xplusinxH/zhufeng-robotic-arm/README.md

# zhufeng-robotic-arm
“zhufeng” The 6（+1）-axis robotic arm utilizes pure vision-based navigation, along with mechanical, control, vision, and hardware components.
