xplusinxH/zhufeng-robotic-arm/machine/README.md

# Machine Part

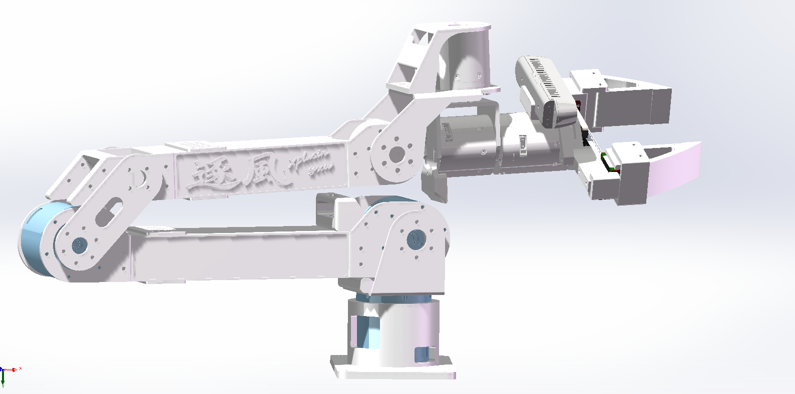
[picture p1: machine/assets/robotic-arm.png]
Robotic arm

零件与装配体使用SOLIDWORKS 2024或更高版本打开

## SUGGETIONS :
* 部分安装场景间距较窄建议使用整体采用平头螺丝
* 齿条建议采用钣金或CNC加工，实测PC耗材 5层墙 80填充密度的3D打印件仍会在远端出现跳齿
* 注意肩部和腕部的装配顺序，不然重复拆装可能会导致~~怒发冲冠~~
