xplusinxH/zhufeng-robotic-arm/docs/进度记录/2026-06-18-当前视觉进度与临时AprilTag任务.md

# 2026-06-18 当前视觉进度与临时 AprilTag 任务记录

## 当前项目进度

截至本记录，Jetson 视觉侧已经完成以下基础能力：

1. Jetson Nano 已完成 D435 运行环境配置。
2. 外部 30 GB 存储已改为 ext4，并挂载到 `/mnt/zhufeng_data`。
3. 项目运行目录改为 `/mnt/zhufeng_data/zhufeng/vision_jeason`。
4. D435 彩色流和深度流可稳定采集。
5. RGB-Depth 对齐验证已通过。
6. 鼠标点击测距和三维坐标显示已验证正常。
7. 已确认 D435 深度测量效果满足当前阶段要求，暂不需要深度尺度校正。

## 已知工作区状态

当前机械部分存在大量 SolidWorks 文件修改和临时锁文件。这些修改不属于视觉代码本次任务范围，
后续视觉侧提交不得自动包含这些 CAD 文件。

## 新增临时任务

用户提供了 Sukinee 机械臂视觉标定任务说明、`AprilTag0.pdf` 和 `AprilTag1.pdf`。
这些文件已备份到：

```text
docs/参考资料/2026-06-18-AprilTag机械臂临时标定任务
```

临时任务目标：

1. 使用相机识别机械臂底座附近的 `tag0`。
2. 使用相机识别执行器末端的 `tag1`。
3. 基于两个 tag 的相对位姿，计算执行器末端在底座 tag 坐标系下的位置。
4. 当对方通过 Jetson 串口发送坐标查询请求时，Jetson 返回当前执行器末端坐标。

## 重要边界

本临时任务只做视觉测量和串口响应：

- 不控制机械臂。
- 不连接 CAN 控制电机。
- 不设置电机零位。
- 不保存电机参数。
- 不启动 MoveIt 真机执行。
- 不做完整联合优化。

## 需要后续确认

1. 串口查询命令的精确格式。
2. 串口返回坐标的精确格式。
3. 返回坐标应使用毫米还是米。
4. 返回的是 `tag1` 原点坐标，还是需要换算到真正工具中心点。
5. `tag0` 和 `tag1` 的实际打印黑白图案边长。
