xplusinxH/zhufeng-robotic-arm/docs/进度记录/2026-06-15-视觉环境与D435采集.md

# 2026-06-15 视觉环境与 D435 采集进度记录

## 今日目标

完成 Jetson Nano 视觉运行环境准备，打通 RealSense D435 的 RGB-D 对齐采集链路，
并确定长期存储布局。

## 已完成事项

1. 确认 Jetson Nano 运行 L4T R32.7.4 / JetPack 4.6.4。
2. 确认 Python 3.6.9 和 OpenCV 3.2.0 可用。
3. 从源码编译并安装 librealsense 2.50.0。
4. 使用 RSUSB 后端，未修改 Jetson 内核。
5. 安装并验证 `pyrealsense2` Python 绑定。
6. 使用 `rs-enumerate-devices` 正确识别 RealSense D435。
7. 完成彩色流、深度流和深度对齐采集验证。
8. 完成 30 帧冒烟测试和十分钟稳定性测试。
9. 实现仓库中的 D435 对齐采集封装和相机检查脚本。
10. 建立独立的 `vision_jeason` Jetson 部署目录。

## 硬件与环境记录

| 项目 | 当前值 |
|---|---|
| Jetson 用户名 | `jetson` |
| L4T | R32.7.4 |
| JetPack | 4.6.4 |
| Python | 3.6.9 |
| OpenCV | 3.2.0 |
| librealsense | 2.50.0 |
| RealSense 后端 | RSUSB |
| D435 序列号 | `243122071071` |
| D435 固件 | `05.15.01.55` |

## 最终存储布局

eMMC 保存系统、运行库、运行配置和标定结果：

```text
/etc/zhufeng-vision/config
/etc/zhufeng-vision/calibration
```

外部 30 GB 存储已格式化为 ext4，UUID 为：

```text
06b4e18a-9a14-4a1e-bec3-8a9ace002fe1
```

固定挂载路径：

```text
/mnt/zhufeng_data
```

项目运行路径：

```text
/mnt/zhufeng_data/zhufeng/vision_project
```

## 问题与处理

### 外部盘只读

外部盘原文件系统为 `vfat`。在其中克隆 Git 仓库并编译动态库时，由于 vfat 不支持
Linux 符号链接，目录结构损坏，内核将文件系统自动设置为只读。

处理过程：

1. 使用 `fsck.vfat` 确认并修复损坏。
2. 将外部盘重新格式化为 ext4。
3. 固定挂载到 `/mnt/zhufeng_data`。
4. 验证 ext4 外部盘可正常读写。

后续不得将 Linux 项目工作盘格式化为 vfat。

### Python 绑定无法导入

`pyrealsense2` 安装在 `/usr/local/lib/python3.6/pyrealsense2`，不在默认搜索路径。
通过以下 `.pth` 配置解决：

```bash
/usr/local/lib/python3.6/dist-packages/pyrealsense2.pth
```

## 当前验收结果

- D435 可通过 USB 3.2 正确识别。
- `pyrealsense2` 可导入。
- 彩色流和深度流均为 640x480、30 FPS。
- 深度帧能够对齐到彩色帧。
- 中心点深度可正常读取。
- 十分钟连续采集无异常。
- 外部 ext4 存储可正常读写。

## 下一阶段

1. 读取并保存 D435 相机内参。
2. 增加 RGB 与深度对齐的可视化验证。
3. 采集空桌面数据。
4. 实现桌面平面标定。
5. 建立相机坐标系到机械臂工作坐标系的标定流程。
