xplusinxH/zhufeng-robotic-arm/docs/参考资料/2026-06-18-AprilTag机械臂临时标定任务/Sukinee机械臂视觉标定任务执行说明-联合优化版.txt

# Sukinee 机械臂视觉标定任务执行说明：联合优化版

## 0. 本任务的目标

本任务不是让视觉系统控制机械臂，也不是做 MoveIt 真机执行。

本任务目标是搭建一条外部视觉测量链路：

```text
固定外部相机
→ 标定后的 camera_info
→ AprilTag 检测
→ 输出末端 tag_tool0 在相机坐标系下的位姿
→ 多姿态采样
→ 和 motor_pos / q_urdf 样本对齐
→ 联合优化 motor_to_urdf software zero offset、base_link -> camera、tool0 -> tag_tool0
```

最终我们希望用视觉测量数据回答：

```text
当前 motor_pos -> q_urdf -> URDF FK 预测出的末端位置，
和真实机械臂末端位置相比误差是多少？

能否通过多姿态视觉样本修正 Joint1-Joint6 的 software zero offset？

能否同时反解：
1. base_link -> camera
2. tool0 -> tag_tool0
从而避免用手测外参？
```

本版第一阶段联合优化：

```text
1. Joint1-Joint6 的 q_urdf 零位修正量 Δq
2. base_link -> camera 的固定外参
3. tool0 -> tag_tool0 的固定外参
```

仍然不优化：

```text
1. 连杆长度
2. 关节轴方向
3. 完整 URDF 几何
4. 电机硬件零位
5. CAN_ID
6. 电机参数
7. MoveIt 真机执行
8. Gazebo effort / damping / torque / gravity_scale 真机参数
```

后续优化完成后，只输出新的 software-only offset JSON，例如：

```text
sukinee_motor_to_urdf_offsets_calibrated.json
```

不会设置电机零位，不会保存电机参数。

---

## 1. 坐标链路说明

### 1.1 坐标系定义

本任务使用 4 个核心坐标系：

```text
B = base_link，机器人底座坐标系
C = camera_color_optical_frame，相机光学坐标系
E = tool0，URDF 里的末端坐标系
T = tag_tool0，贴在末端刚体上的 AprilTag 坐标系
```

记号约定：

```text
T_A_B 表示：从 B 坐标系变换到 A 坐标系。
```

例如：

```text
T_C_T = camera -> tag_tool0
T_B_C = base_link -> camera
T_B_E = base_link -> tool0
T_E_T = tool0 -> tag_tool0
```

### 1.2 AprilTag 直接测出来的量

AprilTag 视觉检测直接输出的是：

```text
T_C_T_i = 第 i 个样本下 camera -> tag_tool0
```

也就是：

```text
tag_tool0 在 camera 坐标系下的位姿。
```

这个量不是手测的，也不是优化出来的，而是每个采样姿态下由视觉系统直接观测得到。

它依赖：

```text
1. 正确的 camera_info
2. 正确的 tag 实测尺寸
3. 图像中稳定检测到 tag 四个角点
4. tag 没有严重反光、模糊、弯曲或遮挡
```

### 1.3 机械臂 FK 给出的量

机械臂侧有：

```text
motor_pos -> q_urdf -> URDF FK
```

当前 software-only 映射是：

```text
q_urdf[j] = sign[j] * (motor_pos[j] - motor_pos_at_urdf_zero[j])
```

URDF / Pinocchio FK 给出：

```text
T_B_E_i = 第 i 个样本下 base_link -> tool0
```

也就是：

```text
tool0 在 base_link 坐标系下的预测位姿。
```

### 1.4 为什么不需要手测 base_link -> camera 和 tool0 -> tag_tool0

我们要联合优化两个固定外参：

```text
T_B_C = base_link -> camera
T_E_T = tool0 -> tag_tool0
```

它们不是手测值。

它们是通过多姿态数据反解出来的固定未知量。

每个样本 i 都应满足：

```text
T_B_C * T_C_T_i ≈ T_B_E_i * T_E_T
```

左边：

```text
T_B_C * T_C_T_i
=
把视觉测到的 camera -> tag_tool0 转到 base_link 坐标系下
```

右边：

```text
T_B_E_i * T_E_T
=
机械臂 FK 算出的 base_link -> tool0
再接上 tool0 -> tag_tool0 的固定安装外参
```

联合优化的目标就是让所有样本的左右两边尽量一致。

### 1.5 优化完成后如何得到视觉测量的 tool0 位姿

优化完成后，我们有：

```text
T_B_C = base_link -> camera
T_E_T = tool0 -> tag_tool0
```

相机实时测到：

```text
T_C_T = camera -> tag_tool0
```

那么视觉测量的：

```text
base_link -> tool0
```

可以由下面公式得到：

```text
T_B_E_visual = T_B_C * T_C_T * inverse(T_E_T)
```

也就是：

```text
base_link -> tool0 的视觉测量值
=
base_link -> camera
*
camera -> tag_tool0
*
tag_tool0 -> tool0
```

其中：

```text
camera -> tag_tool0：
由 AprilTag 每帧直接测量。

base_link -> camera：
由多姿态样本联合优化反解。

tag_tool0 -> tool0：
等于 inverse(tool0 -> tag_tool0)，由多姿态样本联合优化反解。
```

所以不需要 Tony 用尺子精确手测这三个变换。

Tony 和视觉同事只需要保证：

```text
1. 相机采样期间不动
2. tag_tool0 相对末端刚体不动
3. tag_base_ref 相对环境不动
4. camera_info 正确
5. tag_size_m 正确
6. 姿态样本足够丰富
7. robot sample 和 vision sample 的 sample_id 严格一致
```

---

## 2. 角色分工

### 2.1 Tony 负责

因为只有 Tony 有 Ubuntu 24.04 + ROS 2 Jazzy + Sukinee 机械臂环境，所以以下事情必须在 Tony 的电脑和机械臂现场完成：

```text
1. 安装和启动 ROS 2 相关软件
2. 启动 USB 相机节点
3. 加载 camera_info
4. 启动 AprilTag 检测节点
5. 启动 zero_drag 或其他安全拖动方式
6. 操作机械臂移动到采样姿态
7. 记录 Joint1-Joint6 motor_pos
8. 记录 Joint1-Joint6 q_urdf
9. 维护 sample_id
10. 保存 robot sample
11. 保存最终数据
12. 确保 MoveIt 不接真机
13. 确保视觉同事不操作 CAN 或电机
```

### 2.2 视觉同事负责

视觉同事即使没有 Ubuntu/ROS 环境，也可以负责：

```text
1. 确认 tag 打印尺寸和图案质量
2. 指导 tag_tool0 安装
3. 指导 tag_base_ref 安装
4. 指导相机安装位置
5. 检查图像质量
6. 检查 camera_info 是否合理
7. 检查 AprilTag 检测是否稳定
8. 判断每个采样姿态下 tag 是否可用
9. 检查静态 tag 抖动
10. 检查 base_ref start / middle / end 是否漂移
11. 审核 vision samples 数据质量
12. 输出视觉质量报告
```

视觉同事可以远程指导 Tony 操作 ROS 相机和 AprilTag，但不能操作 CAN、电机、MoveIt 真机执行。

---

## 3. 安全边界

视觉同事不要做以下事情：

```text
1. 不接 can0
2. 不控制电机
3. 不发送 Type1 torque_ff
4. 不发送 Type4 disable
5. 不发送 Type6 set zero
6. 不保存电机参数
7. 不修改 CAN_ID
8. 不启动 MoveIt 真机执行
9. 不启动 ros2_control 真机 hardware interface
10. 不让 FollowJointTrajectory 接真实机械臂
```

Tony 操作机械臂时必须保持：

```text
1. MoveIt 只允许 mock/demo
2. MoveIt 不允许真机执行
3. 不设置电机零位
4. 不保存电机参数
5. 不改 CAN_ID
6. Joint7 / left_finger / right_finger 不纳入整臂标定对象
```

stop-all 路径：

```bash
/home/zzj/sukinee_ws/src/sukinee_urdf/scripts/zero_drag/sukinee_stop_all_motors.py
```

如果使用 zero_drag 真实拖动，要明确：

```text
这涉及真实机械臂控制。
zero_drag 可能发送真实 Type1 torque_ff。
zero_drag 结束或异常时应通过 Type4 disable 路径关闭电机。
必须准备 stop-all 脚本。
MoveIt 仍不允许真机执行。
```

can0 准备命令：

```bash
cd /home/zzj/sukinee_ws

sudo ip link set can0 type can bitrate 1000000 restart-ms 100
sudo ip link set can0 up

ip -details -statistics link show can0
```

正常应看到：

```text
can state ERROR-ACTIVE
bitrate 1000000
berr-counter tx 0 rx 0
```

如果出现：

```text
Device or resource busy
```

执行：

```bash
sudo ip link set can0 down
```

然后重新执行上面的 can0 命令。

---

## 4. 推荐硬件与 tag 尺寸

### 4.1 相机

建议使用普通 USB 相机，优先选择：

```text
1. 能在 Linux 下稳定识别为 /dev/video*
2. 分辨率至少 1280x720，最好 1920x1080
3. 支持固定曝光更好
4. 支持固定焦距更好
5. 尽量避免自动对焦来回拉焦
6. 采样期间必须固定，不能手持
```

### 4.2 AprilTag family

建议使用：

```text
tag36h11
```

### 4.3 tag 尺寸

建议：

```text
tag_tool0: 40 mm × 40 mm
tag_base_ref: 60 mm × 60 mm
```

如果末端 40 mm 太大：

```text
tag_tool0: 30 mm × 30 mm
tag_base_ref: 50 mm × 50 mm
```

注意：

```text
这里的尺寸是 AprilTag 黑白图案主体边长，
不是整张纸边长，
不是外部白边边长。
```

打印要求：

```text
1. 100% 原尺寸打印
2. 不要“适合页面”
3. 不要自动缩放
4. 保留白边
5. 贴到硬板上
6. 保持平整
7. 不要弯曲
8. 不要反光
9. 不要皱折
10. 打印后用尺子重新测量 tag 图案主体边长
11. 记录实测尺寸，单位 m
```

tag 尺寸记录不是为了手测外参，而是为了让 AprilTag 正确估计 `camera -> tag_tool0` 的 3D pose。

---

## 5. tag 安装要求

### 5.1 tag_tool0 安装位置

`tag_tool0` 是末端 tag，用来测量真实末端刚体位姿。

必须满足：

```text
1. 不贴在 left_finger
2. 不贴在 right_finger
3. 不贴在任何会随 Joint7 / 夹爪开合运动的部件上
4. 固定在 Joint6 之后、但不随夹爪开合变化的刚性部件上
5. 推荐固定在 Link8 / gripper 固定座 / tool0 附近刚性安装板
6. 可以用硬纸板、泡沫板、薄亚克力、3D 打印片做小旗子支架
7. 支架必须刚性固定，不能晃动
8. 不挡夹爪开合
9. 不碰机械臂自身
10. 尽量朝向相机
```

本版不要求手工精确测量 `tool0 -> tag_tool0`，因为该外参会在联合优化中求解。

但是必须保证：

```text
tag_tool0 相对于末端刚体是固定常量。
```

如果 tag 会晃、会弯、会随 Joint7 开合，那么 `tool0 -> tag_tool0` 就不是常量，数据会失效。

### 5.2 tag_base_ref 安装位置

`tag_base_ref` 是底座附近参考 tag，用于检查相机/环境是否移动。

必须满足：

```text
1. 固定在机器人底座附近的桌面、底板或固定硬板上
2. 不贴在 Joint1 会转动的部分
3. 不要求位于 base_link 原点
4. 采样期间不能移动
5. 采样开始前、结束后、中途偶尔能看到即可
```

本版中 `tag_base_ref` 不直接用于求 `base_link -> camera`，因为 `base_link -> camera` 会由联合优化反解。

`tag_base_ref` 的主要作用是：

```text
1. 采样开始前记录 camera -> tag_base_ref
2. 采样中途记录 camera -> tag_base_ref
3. 采样结束后记录 camera -> tag_base_ref
4. 对比三者，判断相机或 base_ref 是否移动
```

### 5.3 是否要求两个 tag 同时可见

不要求。

规则是：

```text
1. 每个有效采样点必须看到 tag_tool0
2. tag_base_ref 不需要每一帧都看到
3. tag_base_ref 用于采样开始、结束、中途检查相机是否移动
4. 如果某个机械臂姿态看不到 tag_tool0，就跳过该姿态
```

---

## 6. 拍照记录要求

拍照记录不是为了用照片直接计算外参，而是为了排查问题。

照片要证明：

```text
1. tag_tool0 固定在末端刚体上，不随夹爪动
2. tag_base_ref 固定在环境中，不随机械臂动
3. camera 固定在环境中，采样期间不会动
```

创建目录：

```bash
mkdir -p /home/zzj/sukinee_ws/vision_calibration/photos
```

建议保存以下照片：

```text
/home/zzj/sukinee_ws/vision_calibration/photos/tag_tool0_mount.jpg
/home/zzj/sukinee_ws/vision_calibration/photos/tag_tool0_closeup.jpg
/home/zzj/sukinee_ws/vision_calibration/photos/tag_tool0_side.jpg
/home/zzj/sukinee_ws/vision_calibration/photos/tag_tool0_with_fingers.jpg

/home/zzj/sukinee_ws/vision_calibration/photos/tag_base_ref_mount.jpg
/home/zzj/sukinee_ws/vision_calibration/photos/tag_base_ref_closeup.jpg
/home/zzj/sukinee_ws/vision_calibration/photos/tag_base_ref_overview.jpg

/home/zzj/sukinee_ws/vision_calibration/photos/camera_setup.jpg
/home/zzj/sukinee_ws/vision_calibration/photos/camera_setup_mount.jpg
/home/zzj/sukinee_ws/vision_calibration/photos/camera_view_workspace.jpg
```

如果只保留最少 3 张，至少保留：

```text
tag_tool0_mount.jpg
tag_base_ref_mount.jpg
camera_setup.jpg
```

### 6.1 tag_tool0_mount.jpg 怎么拍

主照片应从末端斜前方 45° 拍，画面里同时看到：

```text
1. tag_tool0
2. tag 背后的安装板或支架
3. Link8 / gripper 固定座 / tool0 附近刚性结构
4. left_finger
5. right_finger
6. tag 与夹爪手指的相对关系
```

这张照片必须能证明：

```text
tag_tool0 不在 left_finger / right_finger 上，
也不会随 Joint7 夹爪开合运动。
```

### 6.2 tag_tool0_closeup.jpg 怎么拍

靠近拍 tag，确保看清：

```text
1. 黑白图案
2. 四个角
3. 白边
4. 是否平整
5. 是否反光
6. 是否皱折
7. 是否被胶带遮住
```

### 6.3 tag_tool0_side.jpg 怎么拍

从侧面拍 tag 和支架，重点看：

```text
1. 支架厚度
2. 固定方式
3. 是否软、长、容易晃
4. tag 平面是否弯曲
```

### 6.4 tag_tool0_with_fingers.jpg 怎么拍

让画面同时包含：

```text
1. tag
2. left_finger
3. right_finger
4. 夹爪固定座
```

目的是证明：

```text
手指开合时 tag 不会跟着动。
```

### 6.5 tag_base_ref_mount.jpg 怎么拍

从上方斜拍，画面里同时看到：

```text
1. tag_base_ref
2. 机器人底座
3. Joint1 附近区域
4. 桌面 / 底板 / 固定硬板
```

这张照片必须能证明：

```text
tag_base_ref 不在 Joint1 会旋转的部分上，
而是固定在静止环境中。
```

### 6.6 camera_setup.jpg 怎么拍

拍全局布置，画面里看到：

```text
1. 相机本体
2. 相机支架 / 三脚架 / 固定架
3. 机器人整体
4. tag_tool0 大致工作区
5. tag_base_ref 所在区域
6. 相机和机械臂之间的大致空间关系
```

不要只拍相机特写。

### 6.7 camera_view_workspace.jpg 怎么获取

用 ROS 图像窗口截图。

打开：

```bash
rqt_image_view
```

选择相机图像 topic，例如：

```text
/image_raw
```

或：

```text
/camera/image_raw
```

截图保存为：

```text
/home/zzj/sukinee_ws/vision_calibration/photos/camera_view_workspace.jpg
```

截图中最好能看到：

```text
1. tag_tool0 清晰可见
2. tag 不在画面边缘
3. tag 不是太小
4. 常用工作区覆盖够用
5. 没有严重反光或背光
```

---

## 7. 相机安装位置

推荐位置：

```text
机械臂前上方或侧前上方
俯视角大约 30°–60°
相机固定在三脚架、支架或刚性架上
覆盖常用工作区，不追求覆盖全部极限姿态
```

布置要求：

```text
1. 相机不能手持
2. 采样期间不能移动相机
3. 避免强反光
4. 避免背光
5. 保持光照稳定
6. 机械臂运动后停稳再采样
7. tag 在画面中不要太小
8. tag 不要太靠近画面边缘
9. tag 不要严重倾斜到只剩很窄的透视形状
10. 相机线缆不要拉扯相机
11. 人走动或机械臂运动时不要碰到支架
```

---

## 8. 软件安装

在 Tony 的 Ubuntu 24.04 + ROS 2 Jazzy 环境下执行：

```bash
sudo apt update

sudo apt install -y \
  ros-jazzy-apriltag-ros \
  ros-jazzy-v4l2-camera \
  ros-jazzy-camera-calibration \
  ros-jazzy-image-view \
  ros-jazzy-image-proc \
  ros-jazzy-tf2-ros \
  ros-jazzy-rqt-image-view \
  v4l-utils
```

验证安装：

```bash
source /opt/ros/jazzy/setup.bash

ros2 pkg list | grep apriltag
ros2 pkg list | grep v4l2
ros2 pkg list | grep camera_calibration
ros2 pkg list | grep image_view
```

预期至少能看到：

```text
apriltag_ros
v4l2_camera
camera_calibration
image_view
```

---

## 9. 检查 USB 相机

插入相机后检查设备：

```bash
ls /dev/video*
```

查看相机设备信息：

```bash
v4l2-ctl --list-devices
```

查看相机支持格式：

```bash
v4l2-ctl --device=/dev/video0 --list-formats-ext
```

这里 `/dev/video0` 需要按实际设备修改。

---

## 10. 启动相机节点

先用最小命令测试：

```bash
source /opt/ros/jazzy/setup.bash

ros2 run v4l2_camera v4l2_camera_node \
  --ros-args \
  -p video_device:=/dev/video0 \
  -p image_size:="[1280,720]" \
  -p camera_frame_id:=camera_color_optical_frame
```

另开一个终端检查 topic：

```bash
source /opt/ros/jazzy/setup.bash

ros2 topic list | grep -E "image|camera"
```

检查图像频率：

```bash
ros2 topic hz /image_raw
```

或者如果 topic 带 namespace：

```bash
ros2 topic hz /camera/image_raw
```

打开画面：

```bash
rqt_image_view
```

或：

```bash
ros2 run image_view image_view --ros-args -r image:=/image_raw
```

验收标准：

```text
1. 能看到实时图像
2. 图像不卡死
3. tag 在画面中清楚
4. 不明显过曝
5. 不明显欠曝
6. 不明显运动模糊
7. 相机 frame_id 明确
```

---

## 11. 相机内参标定与验证

本章节不能删除，因为 AprilTag 3D pose 依赖正确 camera_info。

如果相机已经完成内参标定，本章节仍要做“加载验证”。

如果相机更换、分辨率更换、镜头焦距变化、标定 YAML 丢失，则必须重新标定。

### 11.1 为什么必须有正确 camera_info

AprilTag 即使能检测出 ID，如果没有正确 camera_info，3D pose 也不可靠。

必须保证：

```text
1. camera_info 来自当前相机
2. camera_info 对应当前分辨率
3. camera_info 对应当前焦距/镜头设置
4. tag size 使用实际测量尺寸
```

### 11.2 准备标定板

可以使用棋盘格，例如：

```text
棋盘格内角点：8x6
方格尺寸：25 mm
```

实际参数必须按真实标定板填写。

### 11.3 启动相机

```bash
source /opt/ros/jazzy/setup.bash

ros2 run v4l2_camera v4l2_camera_node \
  --ros-args \
  -p video_device:=/dev/video0 \
  -p image_size:="[1280,720]" \
  -p camera_frame_id:=camera_color_optical_frame
```

### 11.4 运行单目标定

如果图像 topic 是 `/image_raw`：

```bash
source /opt/ros/jazzy/setup.bash

ros2 run camera_calibration cameracalibrator \
  --size 8x6 \
  --square 0.025 \
  --ros-args \
  -r image:=/image_raw \
  -r camera:=/camera
```

如果图像 topic 是 `/camera/image_raw`：

```bash
ros2 run camera_calibration cameracalibrator \
  --size 8x6 \
  --square 0.025 \
  --ros-args \
  -r image:=/camera/image_raw \
  -r camera:=/camera
```

标定时移动棋盘格，让它覆盖：

```text
1. 画面左上
2. 画面右上
3. 画面左下
4. 画面右下
5. 画面中心
6. 近距离
7. 远距离
8. 不同倾斜角
```

标定完成后保存 YAML。

### 11.5 保存相机内参

建议保存到：

```bash
mkdir -p ~/.ros/camera_info
```

文件名建议：

```text
sukinee_usb_camera.yaml
```

路径：

```text
~/.ros/camera_info/sukinee_usb_camera.yaml
```

### 11.6 启动相机时加载 camera_info

示例：

```bash
source /opt/ros/jazzy/setup.bash

ros2 run v4l2_camera v4l2_camera_node \
  --ros-args \
  -p video_device:=/dev/video0 \
  -p image_size:="[1280,720]" \
  -p camera_frame_id:=camera_color_optical_frame \
  -p camera_info_url:=file:///home/zzj/.ros/camera_info/sukinee_usb_camera.yaml
```

检查 camera_info：

```bash
ros2 topic echo /camera_info --once
```

或：

```bash
ros2 topic echo /camera/camera_info --once
```

验收标准：

```text
1. camera_info 里 width/height 与图像分辨率一致
2. K 矩阵不是全 0
3. D 畸变参数存在
4. P 矩阵存在
5. header.frame_id 是当前相机 frame
6. 重启相机后 camera_info 仍能加载
```

### 11.7 是否需要 image_proc

如果 AprilTag 节点使用的是 rectified image，例如 `image_rect`，需要启动 `image_proc` 生成 rectified 图像。

如果 AprilTag 节点直接使用 raw image 并配合 camera_info，也可以先按当前节点要求运行。

实际以本机 `apriltag_ros` 的 topic 要求为准。

检查当前 AprilTag 节点需要的输入 topic：

```bash
ros2 pkg executables apriltag_ros
ros2 node info /apriltag_detector
```

如果 node 名不同，用实际 node 名替换。

---

## 12. 创建视觉标定工作目录

```bash
mkdir -p /home/zzj/sukinee_ws/vision_calibration/config
mkdir -p /home/zzj/sukinee_ws/vision_calibration/data
mkdir -p /home/zzj/sukinee_ws/vision_calibration/photos
mkdir -p /home/zzj/sukinee_ws/vision_calibration/reports
mkdir -p /home/zzj/sukinee_ws/vision_calibration/results
```

记录 tag 实测尺寸：

```bash
cat > /home/zzj/sukinee_ws/vision_calibration/config/tag_measured_sizes.yaml <<'YAML'
tag_family: tag36h11

tags:
  tag_tool0:
    id: 0
    measured_size_m: 0.0400
    mounted_on: "Link8 / gripper fixed plate / rigid tool0 bracket"
    moves_with_joint7: false
    used_for: "end-effector calibration"

  tag_base_ref:
    id: 1
    measured_size_m: 0.0600
    mounted_on: "fixed table or fixed base board near robot base"
    moves_with_robot: false
    used_for: "camera drift check only"
YAML
```

注意：

```text
0.0400 和 0.0600 必须换成尺子实际测量的 tag 图案主体边长，单位 m。
```

---

## 13. 配置 AprilTag

建立 AprilTag 配置文件。具体字段名可能需要根据本机安装版本的 `apriltag_ros` 示例微调，但核心信息必须包含：

```bash
cat > /home/zzj/sukinee_ws/vision_calibration/config/apriltag_sukinee.yaml <<'YAML'
family: tag36h11
size: 0.0400

tags:
  - id: 0
    size: 0.0400
    name: tag_tool0
  - id: 1
    size: 0.0600
    name: tag_base_ref
YAML
```

验收标准：

```text
1. tag_tool0 的 id 固定
2. tag_base_ref 的 id 固定
3. tag size 使用实测值
4. frame name 不用 tag0/tag1 这种含糊名字
5. frame name 使用 tag_tool0 / tag_base_ref
```

如果本机 `apriltag_ros` 参数名和上面不同，先查官方示例或执行：

```bash
ros2 pkg prefix apriltag_ros
ros2 pkg executables apriltag_ros
```

---

## 14. 启动 AprilTag 检测

先启动相机，确保 image 和 camera_info 都有。

检查 topic：

```bash
ros2 topic list
```

常见 topic 可能是：

```text
/image_raw
/camera_info
```

也可能是：

```text
/camera/image_raw
/camera/camera_info
```

查看可用 executable：

```bash
ros2 pkg prefix apriltag_ros
ros2 pkg executables apriltag_ros
```

如果有可直接运行的 node，可以按实际 executable 启动，并 remap image/camera_info。

示例 1：

```bash
ros2 run apriltag_ros apriltag_node \
  --ros-args \
  -r image_rect:=/image_raw \
  -r camera_info:=/camera_info \
  --params-file /home/zzj/sukinee_ws/vision_calibration/config/apriltag_sukinee.yaml
```

示例 2：

```bash
ros2 run apriltag_ros apriltag_node \
  --ros-args \
  -r image_rect:=/camera/image_raw \
  -r camera_info:=/camera/camera_info \
  --params-file /home/zzj/sukinee_ws/vision_calibration/config/apriltag_sukinee.yaml
```

检查检测结果：

```bash
ros2 topic list | grep detection
ros2 topic echo /detections --once
```

检查 TF：

```bash
ros2 run tf2_ros tf2_echo camera_color_optical_frame tag_tool0
```

如果 frame 名不同，先查看 TF tree：

```bash
ros2 run tf2_tools view_frames
```

验收标准：

```text
1. /detections 能看到 tag id
2. 检测结果里有 pose
3. tf2_echo 能看到 camera frame 到 tag_tool0 的 transform
4. tag 静止时 transform 不应大幅跳动
5. 移动 tag 后 transform 方向变化符合直觉
```

---

## 15. 静态稳定性测试

这一步必须做。否则后续采样数据不可信。

### 15.1 测试方法

让机械臂和 tag_tool0 完全静止。

条件：

```text
1. 机械臂完全静止
2. 相机完全固定
3. tag_tool0 清晰可见
4. 光照稳定
5. 不碰相机、不碰 tag
```

连续采集 100–200 帧：

```bash
ros2 topic echo /detections > /home/zzj/sukinee_ws/vision_calibration/data/static_tag_tool0_raw.txt
```

同时可以保存 TF：

```bash
ros2 run tf2_ros tf2_echo camera_color_optical_frame tag_tool0 \
  > /home/zzj/sukinee_ws/vision_calibration/data/static_tag_tool0_tf.txt
```

### 15.2 统计内容

统计 tag_tool0 pose 的：

```text
1. x 均值、标准差、最大最小
2. y 均值、标准差、最大最小
3. z 均值、标准差、最大最小
4. roll/pitch/yaw 或 quaternion 抖动
5. 检测成功率
6. 是否有明显跳变帧
```

### 15.3 验收标准

粗略标准：

```text
优秀：静止 position 抖动 1–3 mm
可用：静止 position 抖动 3–5 mm
勉强：静止 position 抖动 5–10 mm
不建议用：静止 position 抖动 > 10 mm 或经常跳变
```

如果静止 tag 的位置抖动达到厘米级，先不要进入多姿态采样，需要先排查：

```text
1. 相机内参不准
2. tag 太小
3. tag 太远
4. 图像模糊
5. 曝光不稳定
6. tag 反光
7. 相机支架晃动
8. tag 支架晃动
9. tag size 填错
10. camera_info 分辨率和实际图像分辨率不一致
```

---

## 16. base_ref 漂移检查

### 16.1 采样开始前

让相机看到 `tag_base_ref`，记录：

```bash
ros2 run tf2_ros tf2_echo camera_color_optical_frame tag_base_ref \
  > /home/zzj/sukinee_ws/vision_calibration/data/base_ref_start_tf.txt
```

### 16.2 采样中途

每 30–40 个有效样本记录一次：

```bash
ros2 run tf2_ros tf2_echo camera_color_optical_frame tag_base_ref \
  > /home/zzj/sukinee_ws/vision_calibration/data/base_ref_middle_001_tf.txt
```

### 16.3 采样结束后

```bash
ros2 run tf2_ros tf2_echo camera_color_optical_frame tag_base_ref \
  > /home/zzj/sukinee_ws/vision_calibration/data/base_ref_end_tf.txt
```

验收标准：

```text
start / middle / end 三次 base_ref 位姿不能明显变化。
如果变化达到几厘米，说明相机或 base_ref 可能移动了，这批样本要标记为可疑或废弃。
```

---

## 17. 采样策略

由于本版要联合优化：

```text
1. Joint1-Joint6 zero offset 修正量
2. base_link -> camera
3. tool0 -> tag_tool0
```

变量比原版更多，所以样本数量必须增加。

### 17.1 小规模试采样

正式采样前先采：

```text
20 个有效样本
```

目的：

```text
1. 验证 robot sample 和 vision sample 能按 sample_id 对齐
2. 验证 AprilTag pose 数据格式可读
3. 验证 FK 数据可读
4. 验证联合优化脚本能跑通
5. 验证 frame 方向没有明显反
6. 验证结果没有明显离谱
```

小样本试采不作为最终标定结果。

### 17.2 正式采样数量

试采通过后，正式采：

```text
训练样本：100 个有效样本
验证样本：20–30 个有效样本
```

最低建议：

```text
训练样本不少于 80 个
验证样本不少于 20 个
```

不建议只采 30 个，因为联合优化变量较多，样本太少容易出现外参和 joint offset 互相混淆。

### 17.3 姿态覆盖要求

样本姿态要覆盖：

```text
1. 左侧
2. 右侧
3. 中间
4. 近处
5. 远处
6. 高位
7. 中位
8. 低位
9. Joint1 有明显变化
10. Joint2 / Joint3 有明显变化
11. Joint4 / Joint5 / Joint6 有适当变化
12. tool0 的位置要变化
13. tool0 的姿态也要变化
```

特别注意：

```text
如果 tool0 姿态几乎不变，tool0 -> tag_tool0 很难被稳定反解。
因此 Joint4 / Joint5 / Joint6 也要有适当变化。
```

不要采：

```text
1. 接近碰撞的姿态
2. 接近机械限位的姿态
3. tag 看不到的姿态
4. tag 在画面边缘的姿态
5. tag 角度太斜的姿态
6. 机械臂还在晃的姿态
7. 相机可能被碰到的姿态
8. Joint7 夹爪状态变化导致 tag 相对末端变化的姿态
```

---

## 18. 每个样本的采样动作

每个样本按以下流程执行。

以 `S0001` 为例：

```text
1. Tony 说：准备采 S0001
2. Tony 负责把机械臂移动到一个安全姿态
3. 停止移动
4. 等待机械臂完全静止 1–2 秒
5. 视觉同事确认 tag_tool0 清晰可见
6. 视觉侧连续取 10–20 帧 camera -> tag_tool0
7. 对 10–20 帧做中位数或稳健平均
8. 视觉侧保存 S0001 的 vision sample
9. Tony 记录 S0001 的 motor_pos 和 q_urdf
10. Tony 保存 S0001 的 robot sample
11. 双方确认 S0001 完成
12. 进入 S0002
```

sample_id 命名建议：

```text
S0001
S0002
S0003
...
```

视觉侧和机械臂侧必须使用相同 sample_id。

不要出现：

```text
视觉侧叫 S0012，robot 侧叫 S0013
```

---

## 19. 视觉侧样本文件格式

建议视觉侧输出 JSONL，每行一个样本。

小样本试采：

```text
/home/zzj/sukinee_ws/vision_calibration/data/vision_samples_trial.jsonl
```

正式训练集：

```text
/home/zzj/sukinee_ws/vision_calibration/data/vision_samples_train_YYYYMMDD.jsonl
```

正式验证集：

```text
/home/zzj/sukinee_ws/vision_calibration/data/vision_samples_validation_YYYYMMDD.jsonl
```

每个有效样本格式：

```json
{
  "sample_id": "S0001",
  "timestamp_vision": "2026-06-xxTxx:xx:xx.xxx",
  "camera_frame": "camera_color_optical_frame",
  "tag_frame": "tag_tool0",
  "tag_family": "tag36h11",
  "tag_id": 0,
  "tag_size_m": 0.0400,
  "T_C_T": {
    "meaning": "camera -> tag_tool0",
    "position": {
      "x": 0.0,
      "y": 0.0,
      "z": 0.0
    },
    "orientation_xyzw": {
      "x": 0.0,
      "y": 0.0,
      "z": 0.0,
      "w": 1.0
    }
  },
  "frame_count_used": 15,
  "detection_quality": {
    "decision_margin": null,
    "hamming": null,
    "center_px": [0.0, 0.0]
  },
  "valid": true,
  "reject_reason": ""
}
```

如果某个样本看不到 tag 或质量差，也可以记录为 invalid：

```json
{
  "sample_id": "S0012",
  "valid": false,
  "reject_reason": "tag_tool0 not visible"
}
```

有效样本必须满足：

```text
1. tag_tool0 可见
2. pose 存在
3. tag id 正确
4. tag size 正确
5. 图像不模糊
6. tag 不在画面边缘
7. 检测没有明显跳变
8. 连续 10–20 帧中没有明显 outlier
```

---

## 20. Tony 侧样本文件格式

Tony 记录 robot side。

小样本试采：

```text
/home/zzj/sukinee_ws/vision_calibration/data/robot_samples_trial.jsonl
```

正式训练集：

```text
/home/zzj/sukinee_ws/vision_calibration/data/robot_samples_train_YYYYMMDD.jsonl
```

正式验证集：

```text
/home/zzj/sukinee_ws/vision_calibration/data/robot_samples_validation_YYYYMMDD.jsonl
```

每行格式建议：

```json
{
  "sample_id": "S0001",
  "timestamp_robot": "2026-06-xxTxx:xx:xx.xxx",
  "offset_file": "/home/zzj/sukinee_ws/sukinee_motor_to_urdf_offsets.json",
  "motor_pos": {
    "Joint1": 0.0,
    "Joint2": 0.0,
    "Joint3": 0.0,
    "Joint4": 0.0,
    "Joint5": 0.0,
    "Joint6": 0.0
  },
  "q_urdf_current": {
    "Joint1": 0.0,
    "Joint2": 0.0,
    "Joint3": 0.0,
    "Joint4": 0.0,
    "Joint5": 0.0,
    "Joint6": 0.0
  }
}
```

注意：

```text
1. 只记录 Joint1-Joint6
2. Joint7 不纳入整臂标定
3. q_urdf_current 使用当前 software offset 计算
4. 不设置电机零位
5. 不保存电机参数
```

---

## 21. 后续建议新建的脚本

后续建议新建目录：

```bash
mkdir -p /home/zzj/sukinee_ws/src/sukinee_urdf/scripts/vision_calibration
```

### 21.1 视觉样本记录脚本

建议文件：

```text
/home/zzj/sukinee_ws/src/sukinee_urdf/scripts/vision_calibration/sukinee_record_vision_sample.py
```

功能：

```text
1. 输入 sample_id
2. 订阅 /detections 或读取 TF
3. 连续采 10–20 帧 tag_tool0 pose
4. 剔除明显跳变帧
5. 输出中位数 pose
6. 保存 vision_samples_*.jsonl
7. 不连接 can0
8. 不控制机械臂
9. 不启动 MoveIt
```

是否涉及真实控制：

```text
不涉及真实控制。
只读相机/AprilTag 数据。
```

### 21.2 robot 样本记录脚本

建议文件：

```text
/home/zzj/sukinee_ws/src/sukinee_urdf/scripts/vision_calibration/sukinee_record_robot_sample.py
```

功能：

```text
1. 输入 sample_id
2. 读取当前 motor_pos Joint1-Joint6
3. 使用当前 offset JSON 计算 q_urdf_current
4. 保存 robot_samples_*.jsonl
5. 不发送控制命令
6. 不启动 MoveIt
7. 不设置零位
8. 不保存参数
```

是否涉及真实控制：

```text
脚本本身不应发送真实控制命令。
但如果 motor_pos 来源于 zero_drag 或真实驱动反馈，运行环境涉及真实机械臂状态读取。
```

### 21.3 联合优化脚本

建议文件：

```text
/home/zzj/sukinee_ws/src/sukinee_urdf/scripts/vision_calibration/sukinee_optimize_zero_offsets_tooltag_camera.py
```

输入：

```text
1. robot_samples_train_YYYYMMDD.jsonl
2. vision_samples_train_YYYYMMDD.jsonl
3. robot_samples_validation_YYYYMMDD.jsonl
4. vision_samples_validation_YYYYMMDD.jsonl
5. /home/zzj/sukinee_ws/sukinee_motor_to_urdf_offsets.json
6. 当前 URDF/xacro 或生成后的 URDF
7. tag_measured_sizes.yaml
```

优化变量：

```text
1. Δq1-Δq6
2. T_B_C = base_link -> camera
3. T_E_T = tool0 -> tag_tool0
```

每个样本的目标：

```text
T_B_C * T_C_T_i ≈ FK(q_i_current + Δq) * T_E_T
```

输出：

```text
1. sukinee_motor_to_urdf_offsets_calibrated.json
2. camera_extrinsic_base_to_camera.yaml
3. tool0_to_tag_tool0.yaml
4. calibration_report_before_after.txt
5. residuals_train.csv
6. residuals_validation.csv
```

是否涉及真实控制：

```text
不涉及真实控制。
这是离线优化脚本。
不发送 CAN。
不控制电机。
不执行 MoveIt。
不改电机参数。
```

---

## 22. 联合优化结果如何写回 software offset

优化脚本建议优化：

```text
Δq1, Δq2, Δq3, Δq4, Δq5, Δq6
```

含义：

```text
q_corrected[j] = q_current[j] + Δq[j]
```

当前公式：

```text
q_current[j] = sign[j] * (motor_pos[j] - zero_old[j])
```

优化后写回新的 software zero：

```text
zero_new[j] = zero_old[j] - sign[j] * Δq[j]
```

注意：

```text
这只是生成新的 software-only offset JSON。
不是设置电机零位。
不是 Type6 set zero。
不是保存电机参数。
```

---

## 23. 每天采样前检查清单

视觉同事检查：

```bash
ros2 topic list
ros2 topic echo /camera_info --once
ros2 topic echo /detections --once
ros2 run tf2_ros tf2_echo camera_color_optical_frame tag_tool0
```

Tony 检查：

```text
1. 机械臂周围安全
2. stop-all 脚本路径明确
3. MoveIt 没有接真机
4. 当前 offset 文件路径明确
5. sample_id 从哪里开始明确
6. tag_tool0 没松
7. tag_base_ref 没动
8. 相机没动
9. 光照没明显变化
10. 图像清晰
11. camera_info 正常
12. base_ref_start 已记录
```

---

## 24. 采样结束后检查

采样结束后，视觉同事需要再次看一次 `tag_base_ref`。

目的：

```text
检查相机/底座关系是否发生变化。
```

如果开始、中途和结束的 base_ref 位姿差很多，说明：

```text
1. 相机可能移动了
2. base_ref 可能移动了
3. 数据可能不能用于标定
```

采样结束后保存：

```text
1. vision_samples_train_YYYYMMDD.jsonl
2. vision_samples_validation_YYYYMMDD.jsonl
3. static_tag_tool0_raw.txt 或 static_tag_report.txt
4. base_ref_start_tf.txt
5. base_ref_middle_*.txt
6. base_ref_end_tf.txt
7. tag_measured_sizes.yaml
8. camera_intrinsics.yaml
9. tag 安装照片
10. 视觉质量报告
```

Tony 保存：

```text
1. robot_samples_train_YYYYMMDD.jsonl
2. robot_samples_validation_YYYYMMDD.jsonl
3. 当前 sukinee_motor_to_urdf_offsets.json 副本
4. 当前 URDF/xacro 或生成后的 URDF
5. 采样当天说明
```

---

## 25. 视觉质量报告模板

视觉同事最终提交一个简短报告：

```text
1. 相机型号：
2. 分辨率：
3. 帧率：
4. 是否完成相机内参标定：
5. camera_info YAML 路径：
6. camera_info 是否已在 ROS 中验证加载：
7. tag family：
8. tag_tool0 id：
9. tag_tool0 实测尺寸：
10. tag_tool0 安装位置：
11. tag_tool0 是否随 Joint7 运动：
12. tag_base_ref id：
13. tag_base_ref 实测尺寸：
14. tag_base_ref 安装位置：
15. 静止 tag_tool0 连续 100–200 帧位置抖动：
16. 小样本试采数量：
17. 正式训练有效样本数量：
18. 正式验证有效样本数量：
19. 无效样本数量：
20. 常见丢失原因：
21. 采样开始/中途/结束 base_ref 是否一致：
22. 是否怀疑相机移动：
23. 是否怀疑 tag 支架晃动：
24. 是否存在明显反光、模糊、遮挡：
25. 备注：
```

---

## 26. 交付物清单

视觉同事最终交付：

```text
1. camera_intrinsics.yaml
2. tag_measured_sizes.yaml
3. apriltag_sukinee.yaml
4. vision_samples_trial.jsonl
5. vision_samples_train_YYYYMMDD.jsonl
6. vision_samples_validation_YYYYMMDD.jsonl
7. static_tag_report.txt
8. base_ref_start_tf.txt
9. base_ref_middle_*.txt
10. base_ref_end_tf.txt
11. tag_tool0_mount.jpg
12. tag_tool0_closeup.jpg
13. tag_tool0_side.jpg
14. tag_tool0_with_fingers.jpg
15. tag_base_ref_mount.jpg
16. tag_base_ref_closeup.jpg
17. tag_base_ref_overview.jpg
18. camera_setup.jpg
19. camera_setup_mount.jpg
20. camera_view_workspace.jpg
21. vision_quality_report.txt
```

Tony 这边交付给后续优化程序：

```text
1. robot_samples_trial.jsonl
2. robot_samples_train_YYYYMMDD.jsonl
3. robot_samples_validation_YYYYMMDD.jsonl
4. vision_samples_trial.jsonl
5. vision_samples_train_YYYYMMDD.jsonl
6. vision_samples_validation_YYYYMMDD.jsonl
7. sukinee_motor_to_urdf_offsets.json
8. 当前 URDF/xacro 或生成后的 URDF
9. tag_measured_sizes.yaml
10. camera_intrinsics.yaml
11. tag 安装照片
12. base_ref 漂移检查文件
```

联合优化脚本最终应输出：

```text
1. sukinee_motor_to_urdf_offsets_calibrated.json
2. camera_extrinsic_base_to_camera.yaml
3. tool0_to_tag_tool0.yaml
4. calibration_report_before_after.txt
5. residuals_train.csv
6. residuals_validation.csv
```

---

## 27. 最终验收标准

这项视觉工作不是“画面里能看到 tag”就算完成。

真正完成的标准是：

```text
1. 相机图像稳定
2. camera_info 是标定后的真实内参
3. camera_info 已经在 ROS 中验证加载
4. tag_tool0 固定在末端刚体上
5. tag_tool0 不随 Joint7 夹爪运动
6. tag_base_ref 固定不动
7. /detections 稳定输出
8. /tf 能输出 camera -> tag_tool0
9. 静止 tag 抖动可接受
10. base_ref start / middle / end 没有明显漂移
11. 小样本 20 个能跑通数据链路
12. 正式训练集 80–100 个以上有效样本
13. 正式验证集 20–30 个有效样本
14. 每个有效样本都有 sample_id
15. 每个有效样本能和 robot sample 对齐
16. 数据质量足够用于联合优化
17. validation after error 明显小于 validation before error
18. 优化出的 Δq 合理
19. 优化出的 base_link -> camera 大致符合真实相机位置
20. 优化出的 tool0 -> tag_tool0 大致符合 tag 实际安装位置
```

---

## 28. 不可信结果的典型表现

如果优化结果出现以下情况，不要直接使用 calibrated offset：

```text
1. validation 误差没有下降
2. train 误差下降但 validation 误差不下降
3. 某个 Δq 大到离谱，例如超过 0.5 rad，需要重点排查
4. tool0 -> tag_tool0 偏移几百毫米，但 tag 实际就在末端附近
5. base_link -> camera 跑到明显不可能的位置
6. 大量样本残差异常大
7. 残差集中在某些 sample_id，怀疑 sample_id 错位
8. base_ref 显示相机采样期间移动过
9. tag_tool0 支架照片显示可能晃动
10. camera_info 分辨率和实际图像分辨率不一致
```

出现这些问题时，优先排查：

```text
1. sample_id 是否错位
2. camera_info 是否正确
3. tag_size_m 是否写错
4. tag frame 方向是否理解反了
5. quaternion 顺序是否 xyzw
6. FK 使用的 URDF 是否为当前主 URDF
7. motor_to_urdf offset 是否为当前文件
8. tag_tool0 是否松动
9. 相机是否移动
10. Joint7 是否在采样中改变并影响 tag
```

---

## 29. 最小执行顺序

### 第一步：硬件固定与拍照

```text
1. 固定相机
2. 固定 tag_tool0
3. 固定 tag_base_ref
4. 拍照记录 tag_tool0
5. 拍照记录 tag_base_ref
6. 拍照记录 camera setup
7. 记录 tag 实测尺寸
```

通过条件：

```text
1. tag_tool0 不在手指上
2. tag_tool0 不随 Joint7 运动
3. tag_base_ref 不随机械臂运动
4. 相机固定可靠
```

### 第二步：相机和 camera_info 验证

```text
1. 启动 v4l2_camera
2. 检查 image topic
3. 检查 camera_info topic
4. 确认 camera_info 已加载
5. 如未标定或不匹配，则重新标定
```

通过条件：

```text
1. 图像稳定
2. camera_info 正确
3. 分辨率匹配
```

### 第三步：AprilTag 检测

```text
1. 配置 tag id 和 tag size
2. 启动 apriltag_ros
3. 检查 /detections
4. 检查 camera -> tag_tool0
5. 检查 tag 静止时是否稳定
```

通过条件：

```text
1. 能稳定识别 tag_tool0
2. camera -> tag_tool0 pose 稳定
```

### 第四步：静态稳定性测试

```text
1. 机械臂不动
2. tag_tool0 不动
3. 相机不动
4. 连续采 100–200 帧
5. 统计抖动
```

通过条件：

```text
静止抖动可接受，没有厘米级跳变。
```

### 第五步：base_ref start 记录

```text
1. 让相机看到 tag_base_ref
2. 保存 base_ref_start_tf.txt
```

通过条件：

```text
base_ref 能稳定识别。
```

### 第六步：20 个小样本试采

```text
1. 采 20 个有效样本
2. 每个样本都有 robot sample
3. 每个样本都有 vision sample
4. sample_id 严格一致
5. 尝试跑一次联合优化
```

通过条件：

```text
数据能对齐，优化脚本能跑通，结果没有明显离谱。
```

### 第七步：正式采样

```text
1. 训练集 80–100 个以上有效样本
2. 验证集 20–30 个有效样本
3. 姿态覆盖左/右/中、近/远、高/中/低
4. Joint1-Joint6 都有适当变化
5. 每 30–40 个样本记录一次 base_ref
6. 结束后记录 base_ref_end
```

通过条件：

```text
样本分布丰富，base_ref 没有明显漂移，数据完整。
```

### 第八步：联合优化和验证

```text
1. 输入 train robot/vision samples
2. 输入 validation robot/vision samples
3. 输入当前 offset JSON
4. 输入当前 URDF
5. 优化 Δq、T_B_C、T_E_T
6. 输出 calibrated offset JSON
7. 输出 before/after residual
8. 检查 validation 误差
```

通过条件：

```text
validation after error 明显下降，且优化结果物理上合理。
```

---

## 30. 一句话总结

视觉同事要做的是：

```text
在 Tony 的 Ubuntu/ROS 环境上协助搭建固定相机 + AprilTag 的测量系统，
稳定输出多个机械臂静止姿态下 camera -> tag_tool0 的位姿数据，
并保证这些数据能和 Tony 记录的 motor_pos / q_urdf 按 sample_id 对齐。
```

Tony 要做的是：

```text
负责机械臂安全移动、记录 motor_pos/q_urdf、保证 MoveIt 不接真机、保证视觉同事不碰 CAN/电机控制，并保存所有 robot sample。
```

联合优化要做的是：

```text
不用手测 base_link -> camera，也不用手测 tool0 -> tag_tool0。
通过多姿态样本同时反解：
1. Joint1-Joint6 zero offset 修正量
2. base_link -> camera
3. tool0 -> tag_tool0
最终生成新的 software-only calibrated offset JSON。
```
