xplusinxH/zhufeng-robotic-arm/docs/superpowers/plans/2026-06-15-D435内参与对齐验证.md

# D435 内参与 RGB-Depth 对齐验证实施计划

> **执行要求：** 使用 `superpowers:subagent-driven-development`（推荐）或
> `superpowers:executing-plans` 按任务逐项实施。步骤使用复选框跟踪。

**目标：** 读取并保存 D435 内参，在 Jetson 屏幕上实时验证 RGB 与深度对齐，并支持点击测量和保存验证数据。

**架构：** 相机封装负责提供对齐帧、内参与设备信息；纯函数模块负责内参序列化和像素转三维坐标；Jetson 工具负责 OpenCV 实时窗口、鼠标交互与数据保存。PC 端只测试纯函数和文件格式，真实画面与交互在 Jetson 真机验收。

**技术栈：** Python 3.6、OpenCV 3.2、NumPy、pyrealsense2、JSON、unittest。

---

## 文件结构

- 修改 `vision/camera/realsense_camera.py`：提供内参、深度比例尺和设备信息。
- 修改 `vision/coordinate/pixel_to_3d.py`：支持输入内参结构并验证深度。
- 新建 `vision/calibration/intrinsic_io.py`：构造和保存内参 JSON。
- 修改 `vision/calibration/calibrate_intrinsic.py`：Jetson 真机读取并保存内参。
- 新建 `vision/tools/alignment_data.py`：生成时间戳目录并保存验证数据。
- 新建 `vision/tools/check_alignment.py`：实时显示、鼠标点击、保存和退出。
- 新建 `vision/tests/test_intrinsic_alignment.py`：PC 端轻量自动测试。
- 同步修改 `vision_jeason` 中对应运行文件。

### 任务 1：内参数据结构与 JSON 保存

**文件：**

- 新建：`vision/calibration/intrinsic_io.py`
- 新建：`vision/tests/test_intrinsic_alignment.py`

- [ ] **步骤 1：编写内参序列化失败测试**

测试构造包含分辨率、焦距、光心、畸变参数、深度比例尺、序列号和固件版本的字典，
并验证 JSON 文件能够完整保存和重新读取。

- [ ] **步骤 2：运行测试并确认失败**

```powershell
py -3.10 -m unittest vision.tests.test_intrinsic_alignment -v
```

预期：因 `calibration.intrinsic_io` 尚不存在而失败。

- [ ] **步骤 3：实现内参 JSON 构造与保存**

实现：

```python
def build_intrinsic_record(color_intrinsics, depth_intrinsics, depth_scale,
                           serial_number, firmware_version, captured_at):
    ...

def save_intrinsic_record(record, output_path):
    ...
```

文件使用 UTF-8 JSON、两空格缩进，并在写入前创建父目录。

- [ ] **步骤 4：运行测试并确认通过**

```powershell
py -3.10 -m unittest vision.tests.test_intrinsic_alignment -v
```

- [ ] **步骤 5：提交**

```bash
git add vision/calibration/intrinsic_io.py vision/tests/test_intrinsic_alignment.py
git commit -m "实现 D435 内参记录保存"
```

### 任务 2：读取 D435 内参与设备信息

**文件：**

- 修改：`vision/camera/realsense_camera.py`
- 修改：`vision/calibration/calibrate_intrinsic.py`

- [ ] **步骤 1：扩展相机封装**

相机启动后保留活动配置，并实现：

```python
def get_color_intrinsics(self): ...
def get_depth_intrinsics(self): ...
def get_depth_scale(self): ...
def get_device_info(self): ...
```

- [ ] **步骤 2：实现真机内参保存命令**

`calibrate_intrinsic.py` 默认写入：

```text
/etc/zhufeng-vision/calibration/camera_intrinsic.json
```

运行成功后打印保存路径、彩色内参、深度内参和深度比例尺。

- [ ] **步骤 3：在 PC 检查 Python 3.6 语法**

```powershell
@'
import ast
from pathlib import Path
for path in [
    Path("vision/camera/realsense_camera.py"),
    Path("vision/calibration/calibrate_intrinsic.py"),
]:
    ast.parse(path.read_text(encoding="utf-8"), feature_version=(3, 6))
print("Python 3.6 语法检查通过")
'@ | py -3.10 -
```

- [ ] **步骤 4：部署并在 Jetson 真机保存内参**

```bash
cd /mnt/zhufeng_data/zhufeng/vision_project
sudo mkdir -p /etc/zhufeng-vision/calibration
sudo chown jetson:jetson /etc/zhufeng-vision/calibration
python3 calibration/calibrate_intrinsic.py
cat /etc/zhufeng-vision/calibration/camera_intrinsic.json
```

预期：JSON 字段完整，分辨率为 640x480，深度比例尺大于 0。

### 任务 3：像素与深度转相机三维坐标

**文件：**

- 修改：`vision/coordinate/pixel_to_3d.py`
- 修改：`vision/tests/test_intrinsic_alignment.py`

- [ ] **步骤 1：编写坐标计算与无效深度失败测试**

覆盖：

- 光心像素在 0.5 米深度时输出 `(0, 0, 0.5)`。
- 非光心像素按针孔模型计算。
- 深度为 0 时返回无效结果。

- [ ] **步骤 2：运行测试并确认失败**

```powershell
py -3.10 -m unittest vision.tests.test_intrinsic_alignment -v
```

- [ ] **步骤 3：实现最小坐标转换**

实现：

```python
def pixel_depth_to_camera(u, v, depth_m, intrinsics):
    ...
```

输入内参使用 `fx`、`fy`、`cx`、`cy` 字段；无效深度返回 `None`。

- [ ] **步骤 4：运行测试并确认通过**

```powershell
py -3.10 -m unittest vision.tests.test_intrinsic_alignment -v
```

### 任务 4：保存对齐验证数据

**文件：**

- 新建：`vision/tools/alignment_data.py`
- 修改：`vision/tests/test_intrinsic_alignment.py`

- [ ] **步骤 1：编写保存目录和测量 JSON 失败测试**

验证：

- 时间戳目录创建在指定根目录下。
- `measurement.json` 包含像素、深度和三维坐标。
- 无效深度能够保存为明确状态。

- [ ] **步骤 2：运行测试并确认失败**

```powershell
py -3.10 -m unittest vision.tests.test_intrinsic_alignment -v
```

- [ ] **步骤 3：实现保存辅助函数**

实现：

```python
def create_capture_directory(root, timestamp): ...
def save_measurement(path, pixel, depth_m, camera_point): ...
```

- [ ] **步骤 4：运行测试并确认通过**

```powershell
py -3.10 -m unittest vision.tests.test_intrinsic_alignment -v
```

### 任务 5：实现 Jetson 实时对齐验证工具

**文件：**

- 新建：`vision/tools/check_alignment.py`
- 使用：`vision/tools/alignment_data.py`
- 使用：`vision/coordinate/pixel_to_3d.py`

- [ ] **步骤 1：实现实时窗口**

窗口并排显示彩色图和对齐后的深度热力图。深度显示范围固定为 0.15 米到 1.20 米，
避免每帧颜色范围变化。

- [ ] **步骤 2：实现鼠标点击测量**

鼠标左键只响应左侧彩色图区域。点击后读取同位置对齐深度，计算并显示：

```text
像素坐标、深度米数、X/Y/Z 相机坐标
```

深度为 0 时显示“无有效深度”。

- [ ] **步骤 3：实现保存与退出**

- `S`：保存 `color.png`、`depth_raw.png`、`depth_colormap.png`、`overlay.png`
  和 `measurement.json`。
- `Q` 或 `Esc`：停止相机并关闭窗口。

默认保存根目录：

```text
/mnt/zhufeng_data/zhufeng/data/alignment
```

- [ ] **步骤 4：检查 Python 3.6 语法**

```powershell
@'
import ast
from pathlib import Path
for path in Path("vision").rglob("*.py"):
    if ".venv" not in path.parts:
        ast.parse(path.read_text(encoding="utf-8"), feature_version=(3, 6))
print("Python 3.6 语法检查通过")
'@ | py -3.10 -
```

### 任务 6：同步 Jetson 部署目录并真机验收

**文件：**

- 同步修改：`vision_jeason/camera/realsense_camera.py`
- 同步新建：`vision_jeason/calibration/intrinsic_io.py`
- 同步修改：`vision_jeason/calibration/calibrate_intrinsic.py`
- 同步修改：`vision_jeason/coordinate/pixel_to_3d.py`
- 同步新建：`vision_jeason/tools/alignment_data.py`
- 同步新建：`vision_jeason/tools/check_alignment.py`

- [ ] **步骤 1：同步运行文件**

保证 `vision` 与 `vision_jeason` 中上述运行文件内容一致，且部署目录不包含测试、缓存或虚拟环境。

- [ ] **步骤 2：上传到 Jetson**

上传目标：

```text
/mnt/zhufeng_data/zhufeng/vision_project
```

- [ ] **步骤 3：运行内参保存**

```bash
cd /mnt/zhufeng_data/zhufeng/vision_project
python3 calibration/calibrate_intrinsic.py
```

- [ ] **步骤 4：运行实时对齐验证**

```bash
python3 tools/check_alignment.py
```

真机验收：

- 左右画面正常显示。
- 点击物体后深度和三维坐标合理。
- 移动物体时彩色区域与深度区域同步。
- 主要边缘无明显大范围错位。
- `S` 键保存五个验证文件。
- `Q` 和 `Esc` 正常退出。

- [ ] **步骤 5：检查保存结果**

```bash
find /mnt/zhufeng_data/zhufeng/data/alignment -maxdepth 2 -type f | sort
```

预期：每个保存目录包含五个验证文件。

### 任务 7：记录阶段结果

**文件：**

- 修改：`vision/README.md`
- 新建：`docs/进度记录/2026-06-15-D435内参与对齐验证.md`

- [ ] **步骤 1：记录内参数值、对齐观察和保存结果**

以中文记录实际 `fx`、`fy`、`cx`、`cy`、深度比例尺、测试场景和结论。

- [ ] **步骤 2：运行最终 PC 端检查**

```powershell
py -3.10 -m unittest vision.tests.test_intrinsic_alignment -v
```

- [ ] **步骤 3：提交文档**

```bash
git add vision/README.md docs/进度记录/2026-06-15-D435内参与对齐验证.md
git commit -m "记录 D435 内参与对齐验证结果"
```

## 计划自审

- 已覆盖内参读取与保存、实时显示、点击测量、保存数据、错误处理和真机验收。
- PC 端仅测试纯函数、文件格式和 Python 3.6 兼容，不模拟复杂硬件交互。
- Jetson 真机负责验证实际对齐效果、鼠标交互和相机资源释放。
- 所有 Markdown 文档使用中文。
