xplusinxH/zhufeng-robotic-arm/vision_jeason/models/模型说明.md

# 模型目录

后续使用的轻量级检测或分类模型存放在本目录。

模型文件应保存在外部存储中，不要复制到 eMMC。当前 D435 采集验证阶段不需要模型文件。
