xplusinxH/zhufeng-robotic-arm/sukinee_ws/vision_calibration/data/run_100_20260619_012357/gate5_result_77mm_exclude_P0021_P0008/residuals_train.csv

sample_id | relative_pose_source | base_ref_source | weight | before_translation_error_m | before_rotation_error_rad | after_translation_error_m | after_rotation_error_rad | improved_translation_m | improved_rotation_rad
P0001 | same_frame | live | 1.0 | 0.0057890058809896925 | 0.04109257186886733 | 0.004723470198493708 | 0.03740142706700289 | 0.0010655356824959845 | 0.0036911448018644363
P0002 | same_frame | live | 1.0 | 0.005035009544189335 | 0.027972085911446853 | 0.0035401739993135214 | 0.027916740091055554 | 0.0014948355448758137 | 5.5345820391298345e-05
P0003 | same_frame | live | 1.0 | 0.0032580185754006235 | 0.016725949977917143 | 0.0023508674856879837 | 0.027592451231960875 | 0.0009071510897126398 | -0.010866501254043731
P0004 | same_frame | live | 1.0 | 0.004320412303190042 | 0.0303570582659603 | 0.002726880397011936 | 0.01874888765594947 | 0.0015935319061781057 | 0.011608170610010831
P0005 | same_frame | live | 1.0 | 0.007715649025254963 | 0.03671496036162823 | 0.007440119761338214 | 0.013113281872728777 | 0.00027552926391674875 | 0.023601678488899457
P0006 | same_frame | live | 1.0 | 0.002421637526877958 | 0.027916591017849456 | 0.0033531590999728972 | 0.04355420472887695 | -0.0009315215730949394 | -0.015637613711027495
P0007 | same_frame | live | 1.0 | 0.006302751483535289 | 0.037047756892248394 | 0.006119201637818091 | 0.026661353232956448 | 0.00018354984571719753 | 0.010386403659291946
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
P0100 | same_frame | live | 1.0 | 0.0019770863533630366 | 0.007849209762229345 | 0.0014599156636325866 | 0.006053841613909928 | 0.00051717068973045 | 0.001795368148319417
