xplusinxH/zhufeng-robotic-arm/machine/bettery system/电源系统.SLDASM

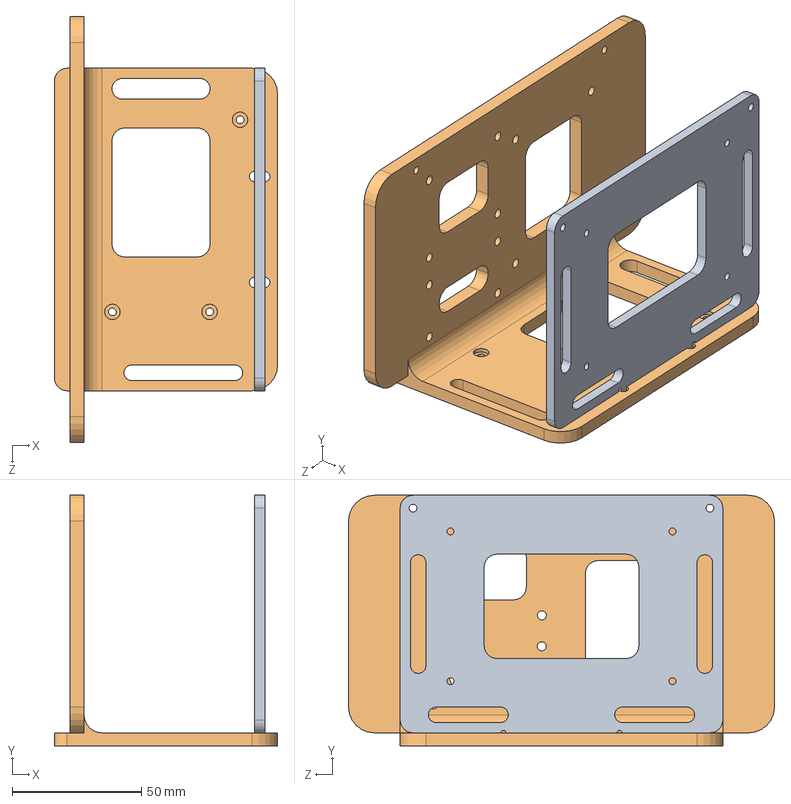
[picture p2: CAD file, 2026-06-28]
machine/bettery system/电源系统.SLDASM
86.5 x 97.0 x 165.0 mm
电源底板
沁恒固定板
