xplusinxH/zhufeng-robotic-arm/machine/bettery system/电源底板.SLDPRT

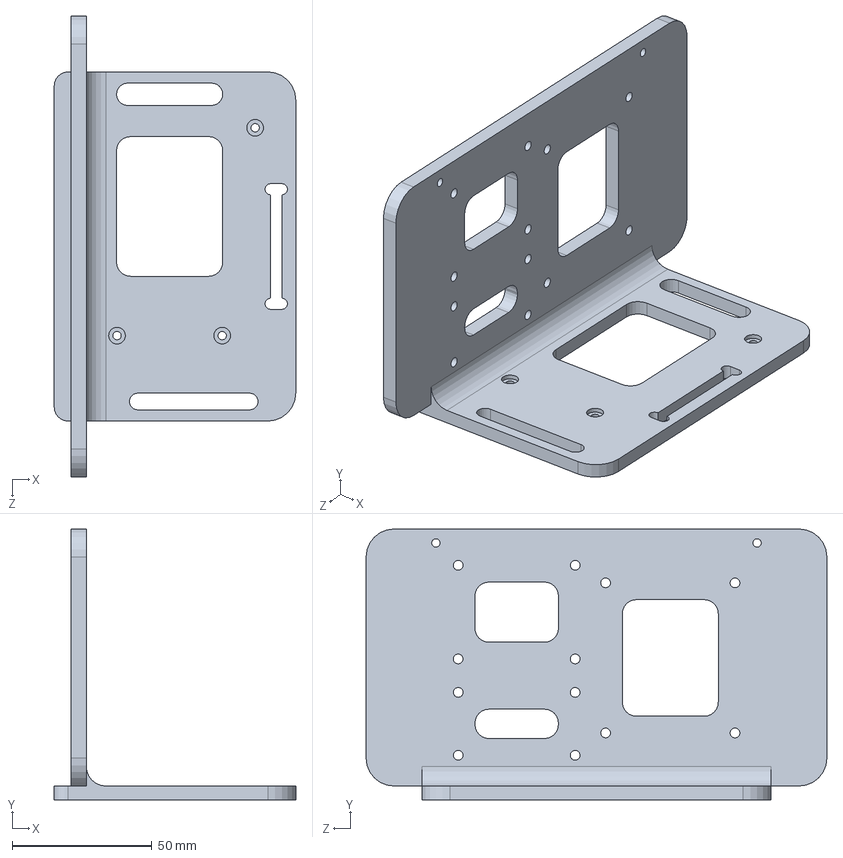
[picture p3: CAD file, 2026-06-28]
machine/bettery system/电源底板.SLDPRT
86.5 x 97.0 x 165.0 mm
