xplusinxH/zhufeng-robotic-arm/machine/sukinee/小臂钣金右2.SLDPRT

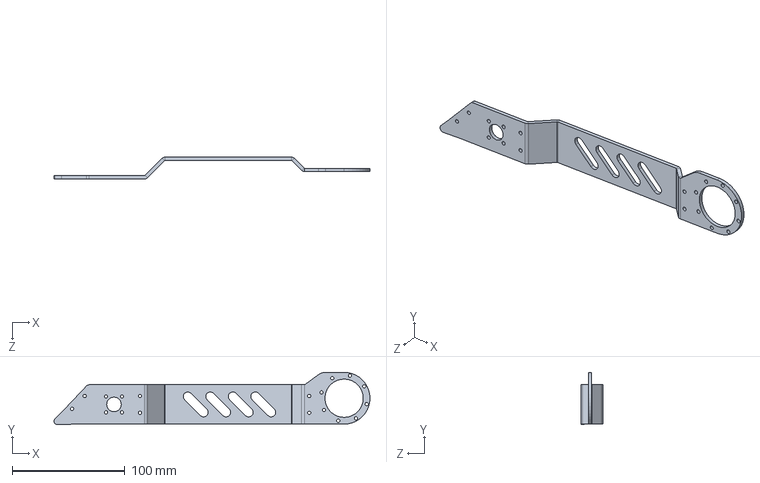
[picture p4: CAD file, 2026-06-28]
machine/sukinee/小臂钣金右2.SLDPRT
280.8 x 46.5 x 19.5 mm
