xplusinxH/zhufeng-robotic-arm/sukinee_ws/src/sukinee_urdf/meshes/urdf_camera_gripper/Link_l.STL

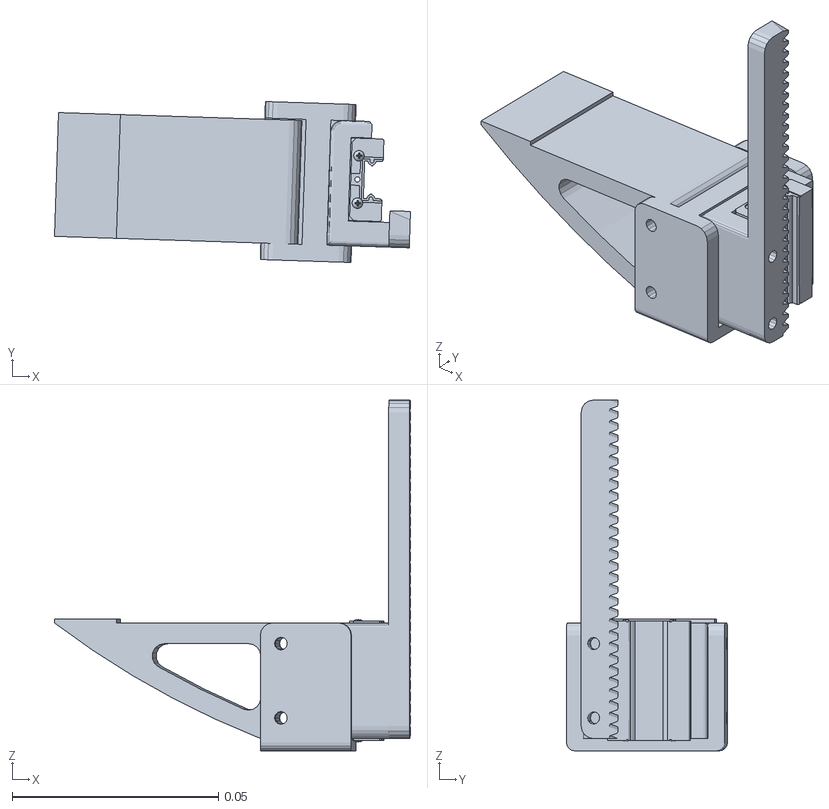
[picture p5: CAD file, 2026-06-14]
sukinee_ws/src/sukinee_urdf/meshes/urdf_camera_gripper/Link_l.STL
0.0862 x 0.039 x 0.085
