xplusinxH/zhufeng-robotic-arm/machine/bettery system/沁恒固定板.SLDPRT

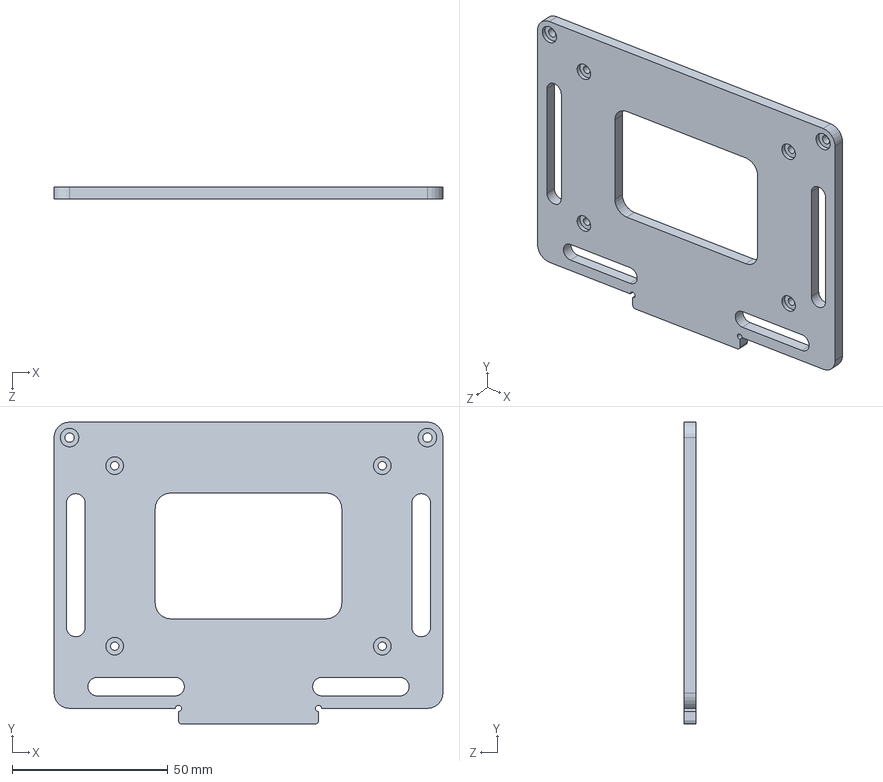
[picture p6: CAD file, 2026-06-28]
machine/bettery system/沁恒固定板.SLDPRT
125.0 x 97.0 x 4.00 mm
