xplusinxH/zhufeng-robotic-arm/machine/sukinee/小臂牌.SLDPRT

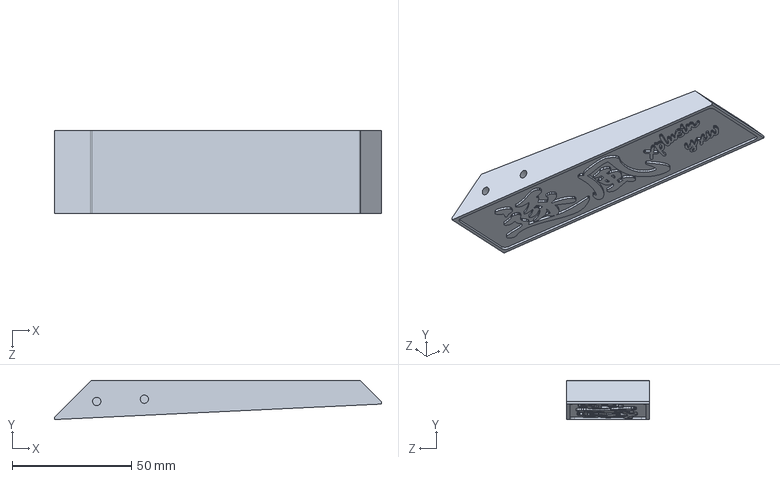
[picture p7: CAD file, 2026-06-28]
machine/sukinee/小臂牌.SLDPRT
137.1 x 16.4 x 35.0 mm
