xplusinxH/zhufeng-robotic-arm/sukinee_ws/src/sukinee_urdf/meshes/urdf_camera_gripper/Link2.STL

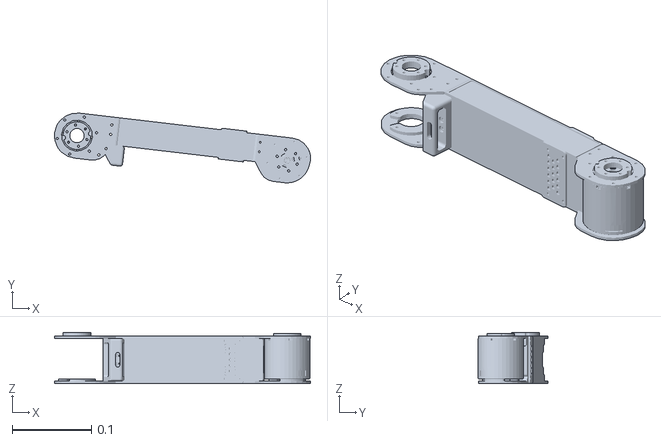
[picture p8: CAD file, 2026-06-14]
sukinee_ws/src/sukinee_urdf/meshes/urdf_camera_gripper/Link2.STL
0.322 x 0.0878 x 0.0644
