xplusinxH/zhufeng-robotic-arm/machine/sukinee/D435固定.SLDPRT

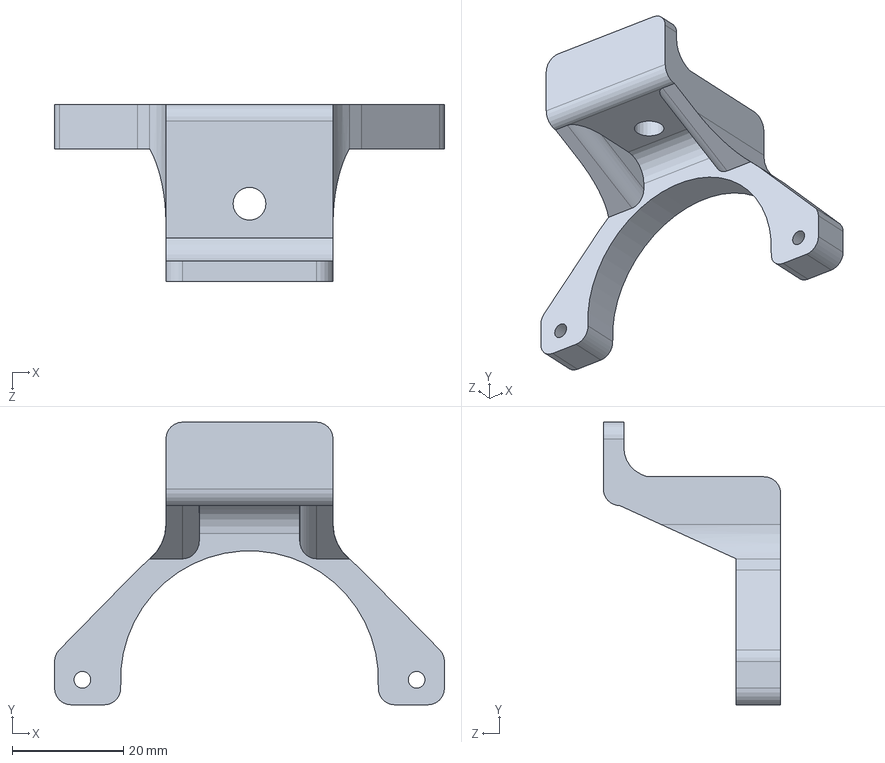
[picture p9: CAD file, 2026-06-28]
machine/sukinee/D435固定.SLDPRT
70.0 x 50.8 x 31.8 mm
