xplusinxH/zhufeng-robotic-arm/sukinee_ws/src/sukinee_urdf/meshes/urdf_camera_gripper/Link8.STL

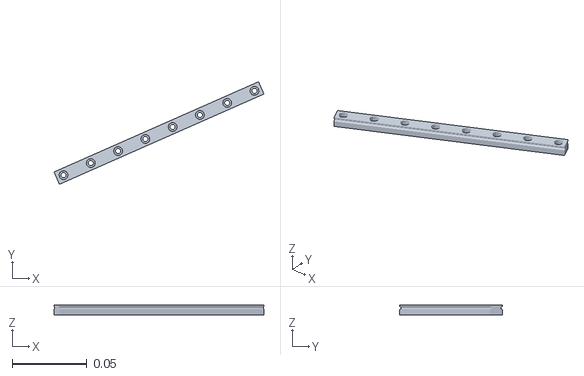
[picture p10: CAD file, 2026-06-14]
sukinee_ws/src/sukinee_urdf/meshes/urdf_camera_gripper/Link8.STL
0.141 x 0.0688 x 0.0065
