xplusinxH/zhufeng-robotic-arm/machine/sukinee/桌面.SLDPRT

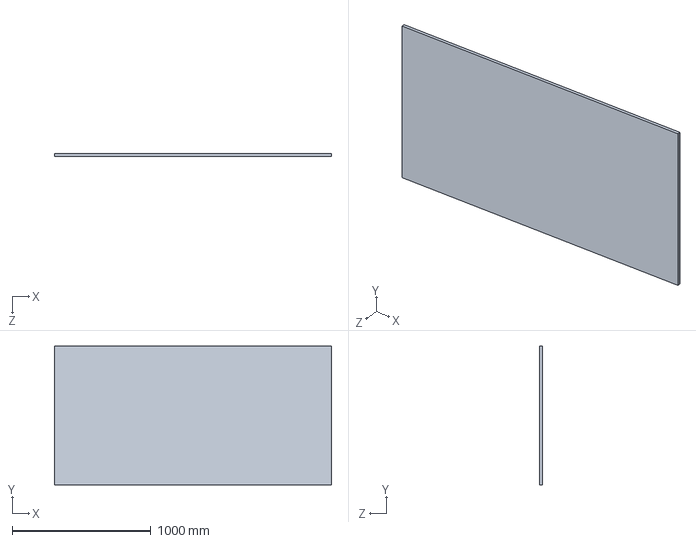
[picture p11: CAD file, 2026-06-28]
machine/sukinee/桌面.SLDPRT
2000.0 x 1000.0 x 20.0 mm
