xplusinxH/zhufeng-robotic-arm/sukinee_ws/src/sukinee_urdf/meshes/urdf_camera_gripper/Link_r.STL

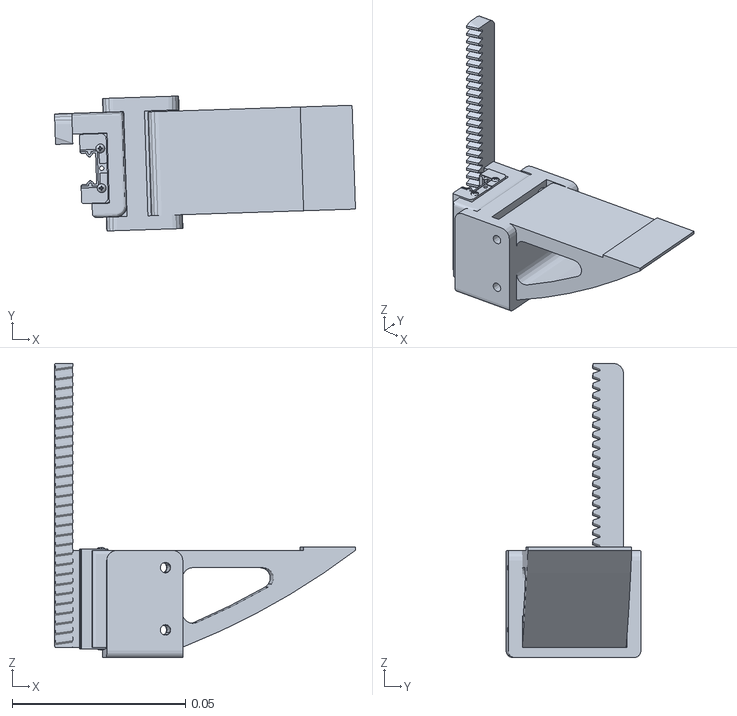
[picture p12: CAD file, 2026-06-14]
sukinee_ws/src/sukinee_urdf/meshes/urdf_camera_gripper/Link_r.STL
0.0869 x 0.039 x 0.085
