xplusinxH/zhufeng-robotic-arm/machine/sukinee/垫片2.SLDPRT

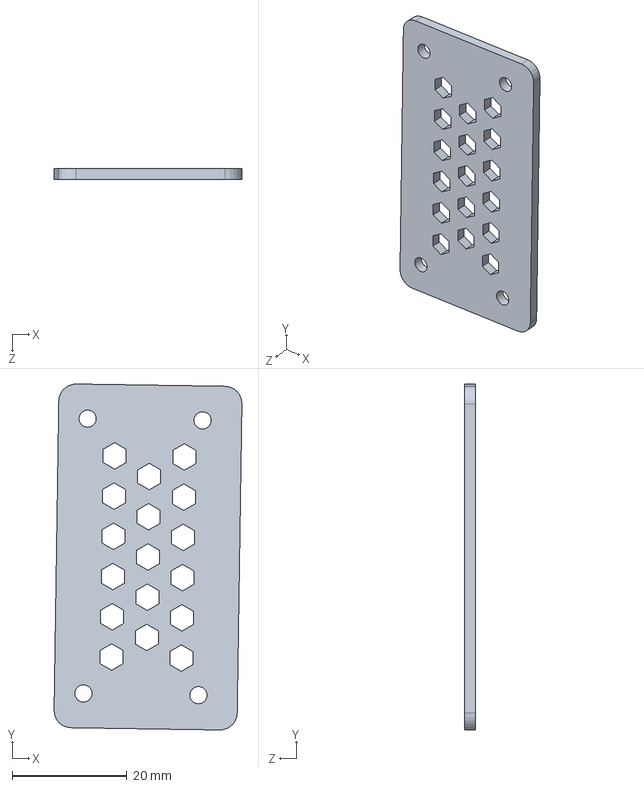
[picture p13: CAD file, 2026-06-28]
machine/sukinee/垫片2.SLDPRT
32.7 x 60.2 x 2.00 mm
