xplusinxH/zhufeng-robotic-arm/sukinee_ws/src/sukinee_urdf/meshes/urdf_camera_gripper/Link7.STL

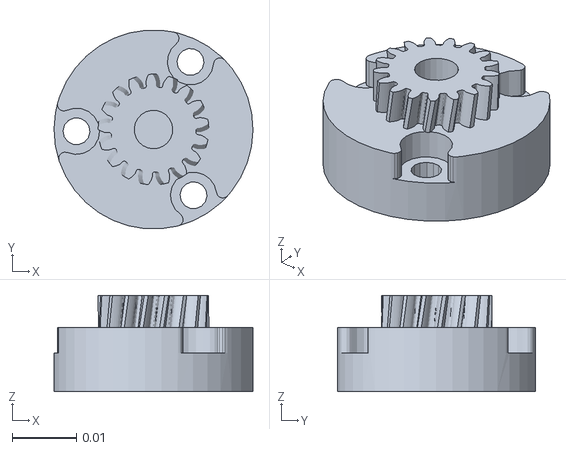
[picture p14: CAD file, 2026-06-14]
sukinee_ws/src/sukinee_urdf/meshes/urdf_camera_gripper/Link7.STL
0.031 x 0.0309 x 0.015
