xplusinxH/zhufeng-robotic-arm/machine/sukinee/Mirror大臂外牌.SLDPRT

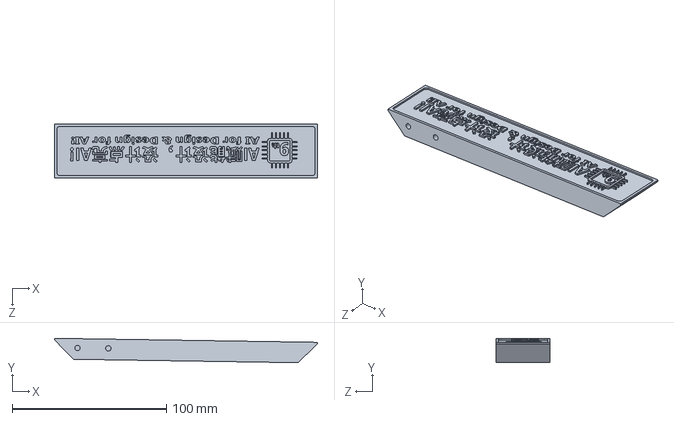
[picture p15: CAD file, 2026-06-28]
machine/sukinee/Mirror大臂外牌.SLDPRT
170.6 x 15.8 x 35.0 mm
