xplusinxH/zhufeng-robotic-arm/machine/sukinee/小臂.SLDPRT

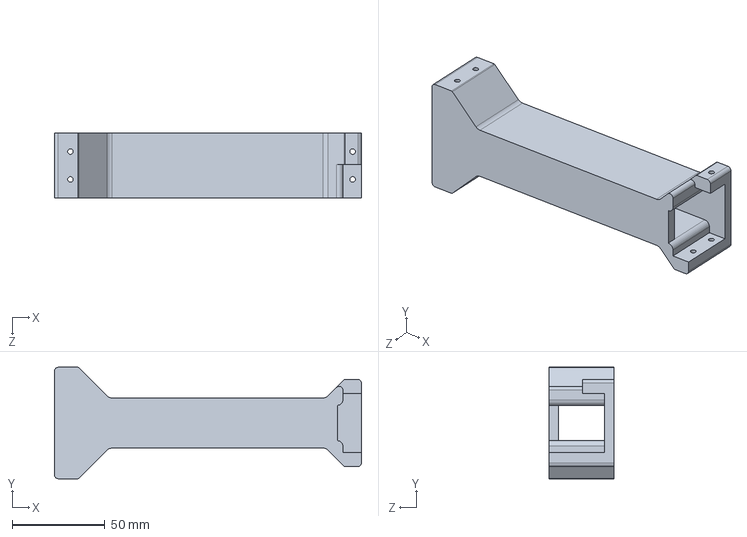
[picture p17: CAD file, 2026-06-28]
machine/sukinee/小臂.SLDPRT
165.2 x 60.0 x 35.0 mm
