xplusinxH/zhufeng-robotic-arm/machine/sukinee/齿条L82W5M 0.9斜.SLDPRT

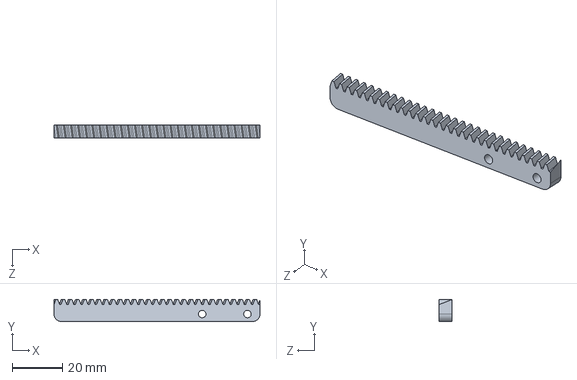
[picture p19: CAD file, 2026-06-28]
machine/sukinee/齿条L82W5M 0.9斜.SLDPRT
82.0 x 8.82 x 5.00 mm
