xplusinxH/zhufeng-robotic-arm/machine/sukinee/腕部初始限位.SLDPRT

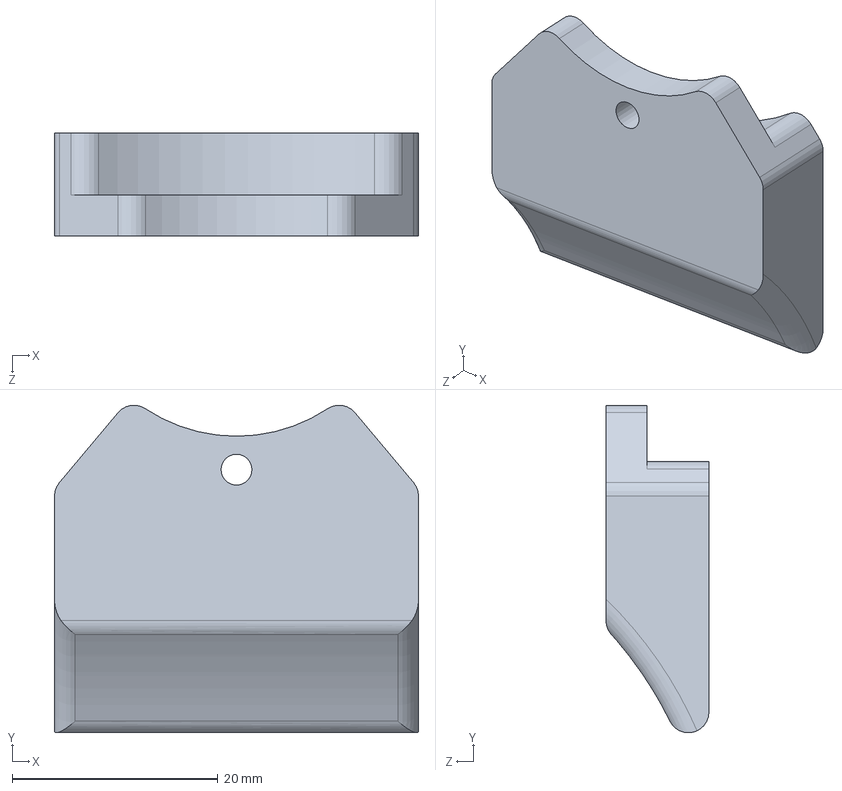
[picture p20: CAD file, 2026-06-28]
machine/sukinee/腕部初始限位.SLDPRT
35.4 x 31.8 x 10.0 mm
