xplusinxH/zhufeng-robotic-arm/machine/sukinee/大臂填充.SLDPRT

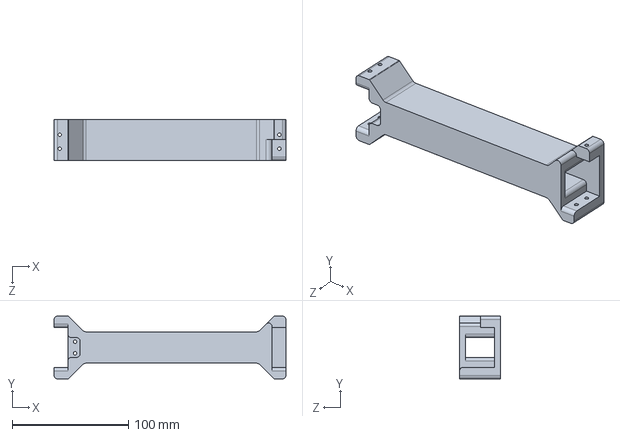
[picture p21: CAD file, 2026-06-28]
machine/sukinee/大臂填充.SLDPRT
199.4 x 54.0 x 35.0 mm
