xplusinxH/zhufeng-robotic-arm/machine/sukinee/牌子垫片.SLDPRT

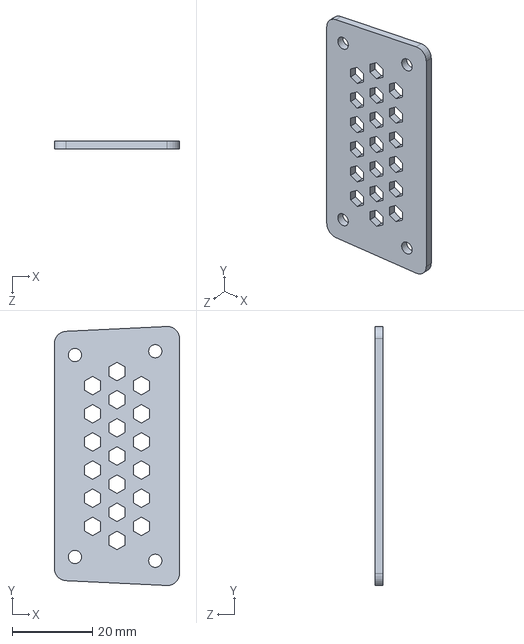
[picture p22: CAD file, 2026-06-28]
machine/sukinee/牌子垫片.SLDPRT
31.1 x 64.4 x 2.00 mm
