xplusinxH/zhufeng-robotic-arm/machine/sukinee/夹爪连接打印件.SLDPRT

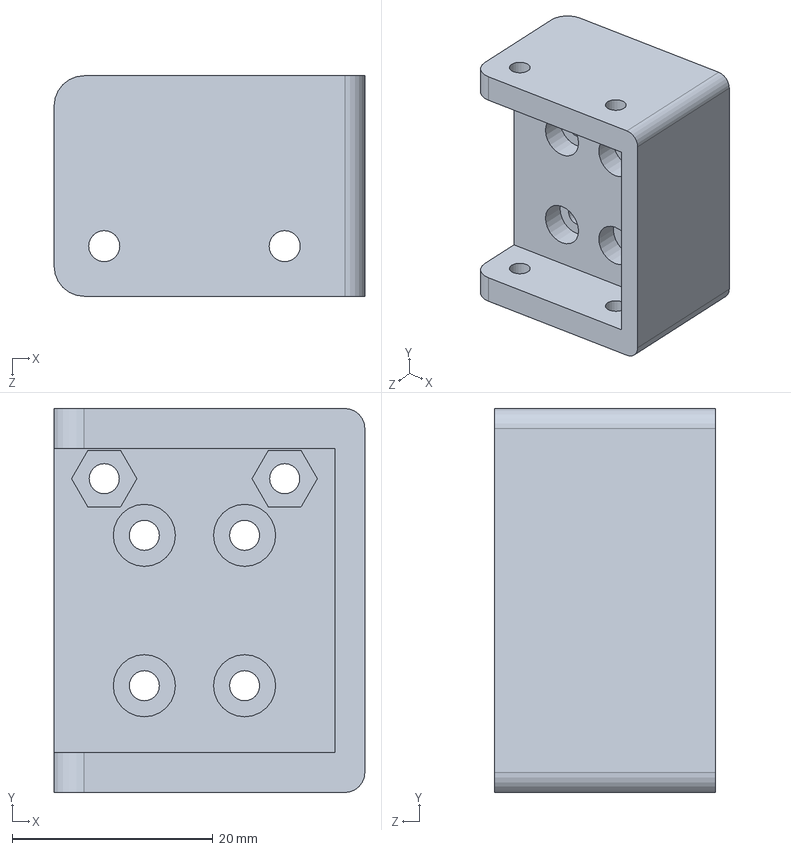
[picture p23: CAD file, 2026-06-18]
machine/sukinee/夹爪连接打印件.SLDPRT
31.0 x 38.3 x 22.0 mm
