xplusinxH/zhufeng-robotic-arm/machine/sukinee/第一级大臂.SLDPRT

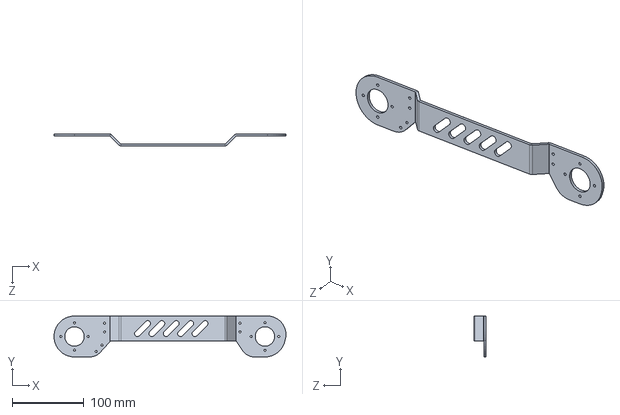
[picture p24: CAD file, 2026-06-18]
machine/sukinee/第一级大臂.SLDPRT
322.8 x 57.0 x 16.5 mm
