xplusinxH/zhufeng-robotic-arm/machine/sukinee/夹爪.SLDPRT

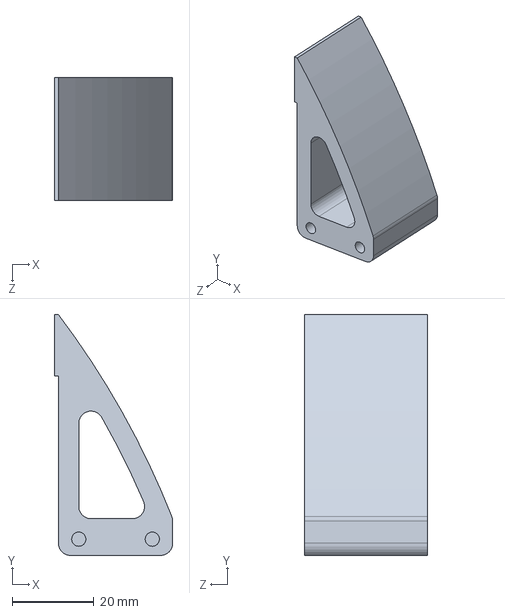
[picture p26: CAD file, 2026-06-18]
machine/sukinee/夹爪.SLDPRT
29.0 x 59.0 x 30.0 mm
