xplusinxH/zhufeng-robotic-arm/machine/sukinee/腕区连接打印件2.SLDPRT

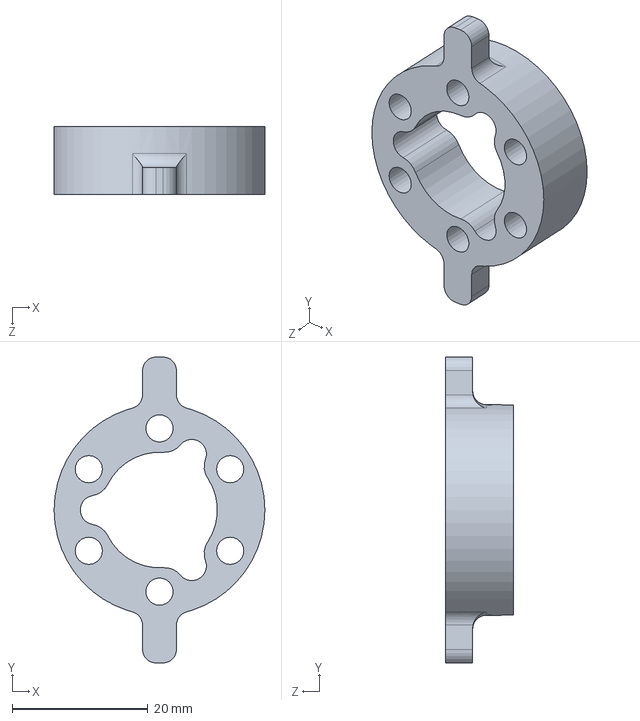
[picture p27: CAD file, 2026-06-05]
machine/sukinee/腕区连接打印件2.SLDPRT
31.0 x 45.0 x 10.0 mm
