xplusinxH/zhufeng-robotic-arm/machine/sukinee/肘部限位打印件.SLDPRT

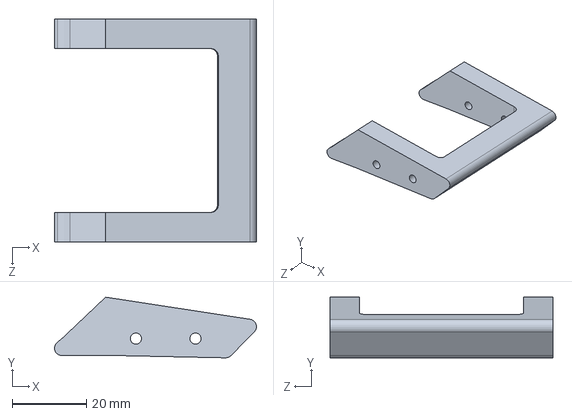
[picture p28: CAD file, 2026-06-05]
machine/sukinee/肘部限位打印件.SLDPRT
54.2 x 16.3 x 60.0 mm
