xplusinxH/zhufeng-robotic-arm/machine/sukinee/肩部限位垫块.SLDPRT

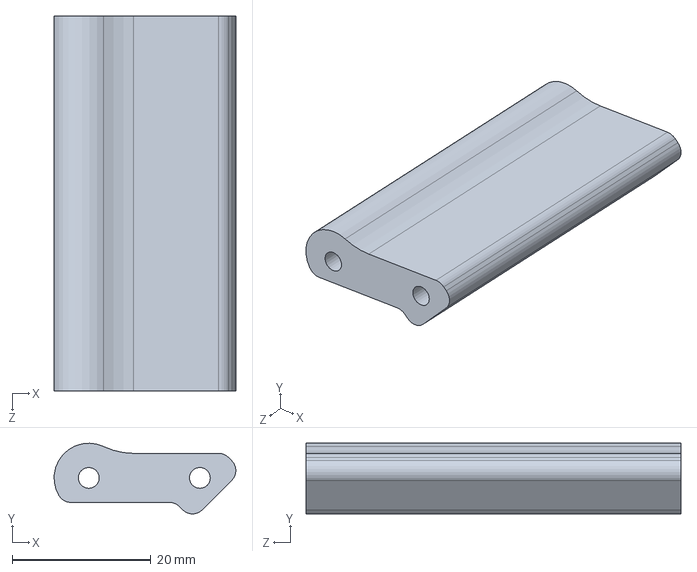
[picture p29: CAD file, 2026-06-05]
machine/sukinee/肩部限位垫块.SLDPRT
26.1 x 10.2 x 54.0 mm
