xplusinxH/zhufeng-robotic-arm/machine/sukinee/腕连接钣金.SLDPRT

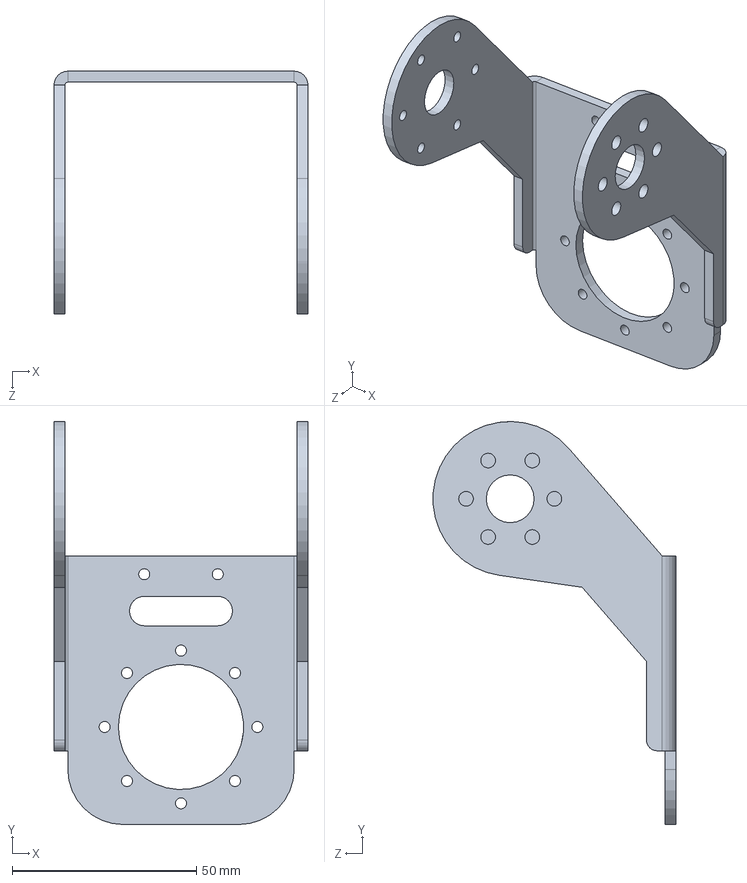
[picture p30: CAD file, 2026-06-05]
machine/sukinee/腕连接钣金.SLDPRT
69.0 x 109.5 x 65.9 mm
