xplusinxH/zhufeng-robotic-arm/machine/sukinee/肩部垫片.SLDPRT

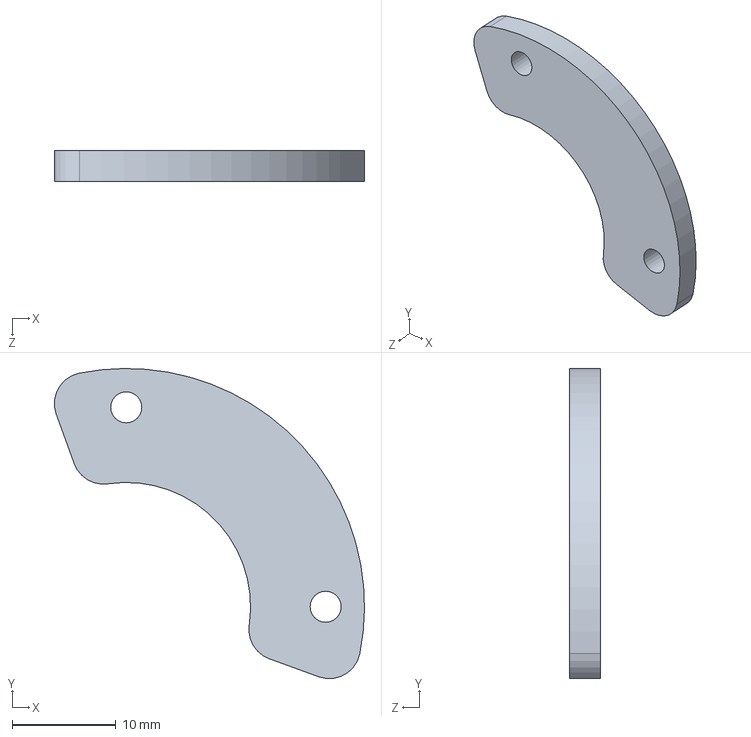
[picture p31: CAD file, 2026-06-05]
machine/sukinee/肩部垫片.SLDPRT
29.9 x 29.9 x 3.00 mm
