xplusinxH/zhufeng-robotic-arm/machine/sukinee/大臂垫片.SLDPRT

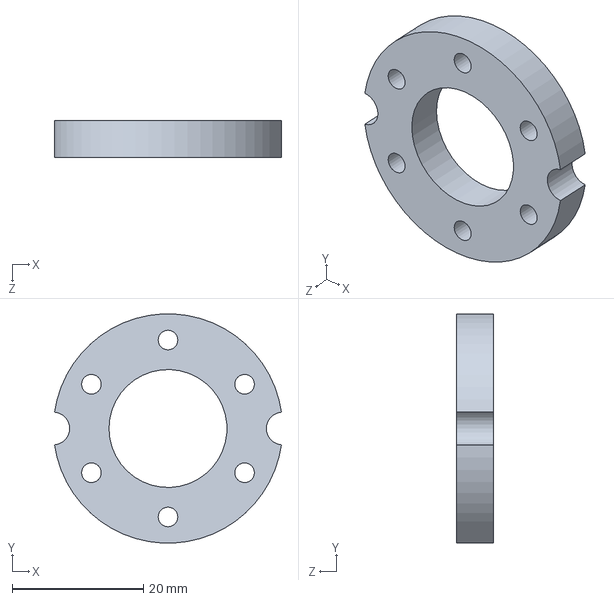
[picture p32: CAD file, 2026-06-05]
machine/sukinee/大臂垫片.SLDPRT
34.6 x 34.9 x 5.60 mm
