xplusinxH/zhufeng-robotic-arm/machine/sukinee/肘部垫片.SLDPRT

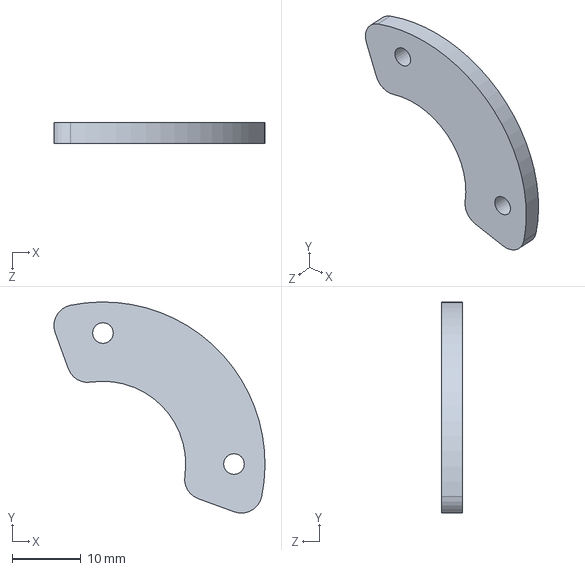
[picture p33: CAD file, 2026-06-05]
machine/sukinee/肘部垫片.SLDPRT
30.6 x 30.6 x 3.00 mm
