xplusinxH/zhufeng-robotic-arm/machine/sukinee/小臂填充.SLDPRT

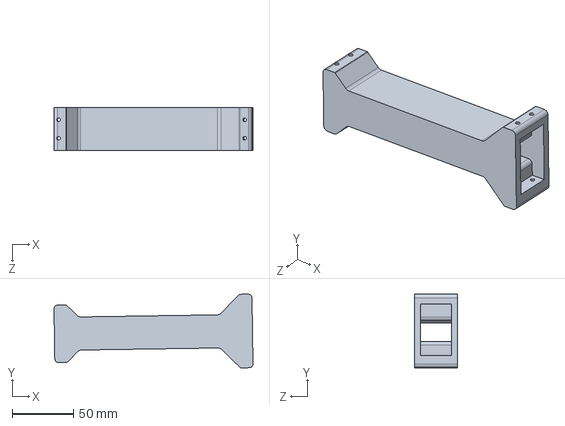
[picture p34: CAD file, 2026-06-05]
machine/sukinee/小臂填充.SLDPRT
162.2 x 60.1 x 35.0 mm
