xplusinxH/zhufeng-robotic-arm/machine/sukinee/夹爪自旋连接2.SLDPRT

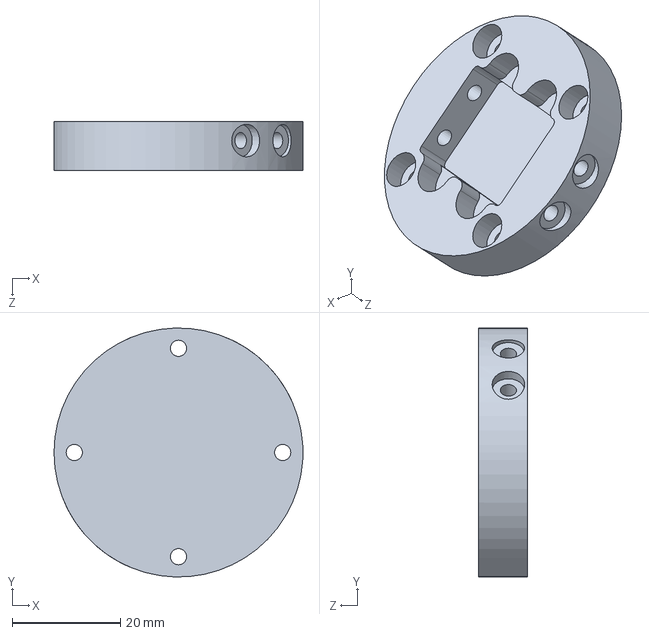
[picture p35: CAD file, 2026-06-05]
machine/sukinee/夹爪自旋连接2.SLDPRT
46.0 x 46.0 x 9.00 mm
