xplusinxH/zhufeng-robotic-arm/machine/sukinee/腕部电机壳.SLDPRT

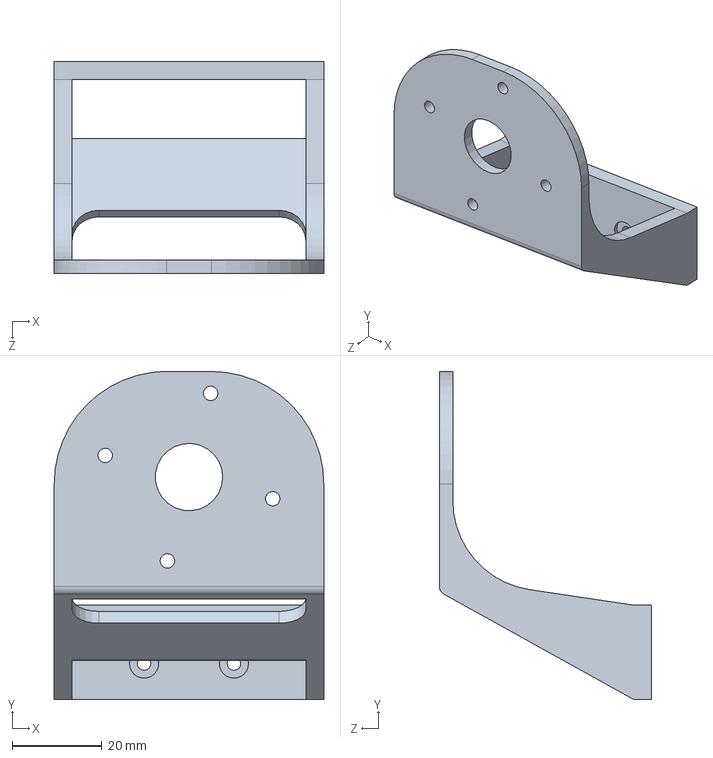
[picture p36: CAD file, 2026-06-05]
machine/sukinee/腕部电机壳.SLDPRT
60.0 x 73.0 x 47.2 mm
