xplusinxH/zhufeng-robotic-arm/machine/sukinee/底板.SLDPRT

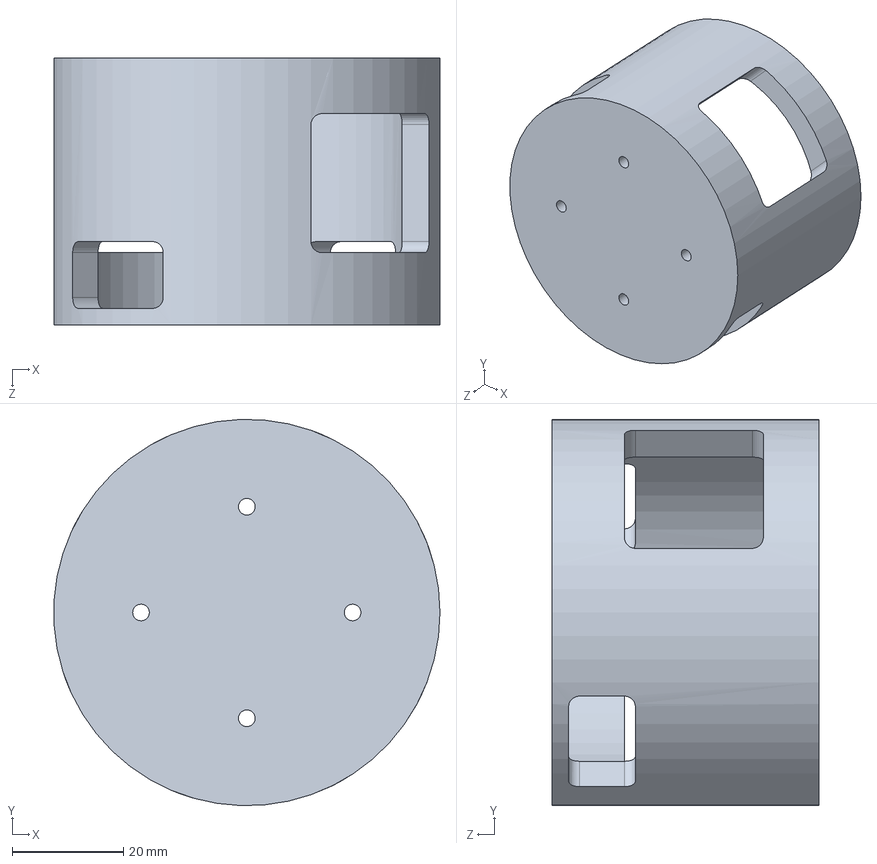
[picture p37: CAD file, 2026-06-05]
machine/sukinee/底板.SLDPRT
69.3 x 69.4 x 48.0 mm
