xplusinxH/zhufeng-robotic-arm/machine/sukinee/肘部连接件.SLDPRT

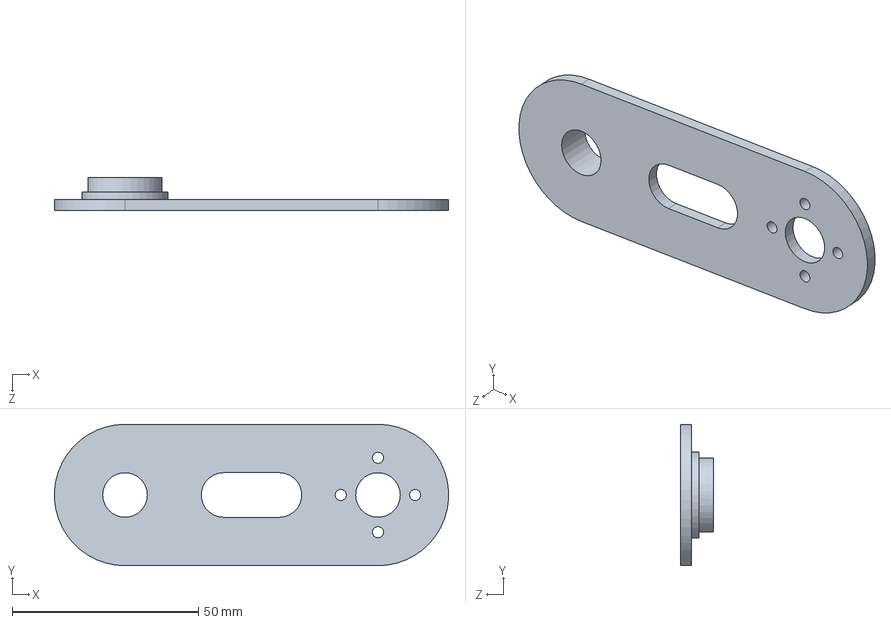
[picture p38: CAD file, 2026-06-05]
machine/sukinee/肘部连接件.SLDPRT
105.9 x 38.0 x 9.00 mm
