xplusinxH/zhufeng-robotic-arm/machine/sukinee/肩部垫块.SLDPRT

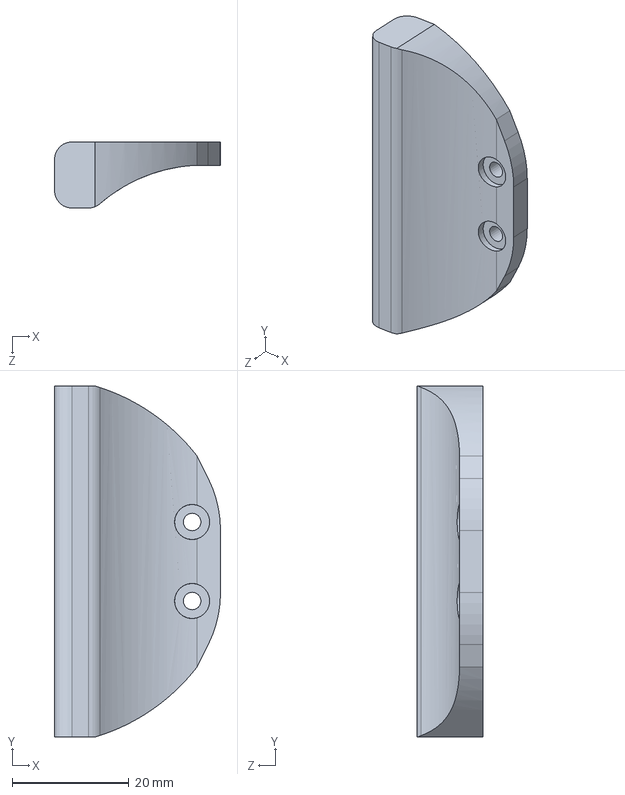
[picture p39: CAD file, 2026-06-05]
machine/sukinee/肩部垫块.SLDPRT
28.4 x 60.0 x 11.3 mm
