xplusinxH/zhufeng-robotic-arm/machine/sukinee/MGN9 Rail1.SLDPRT

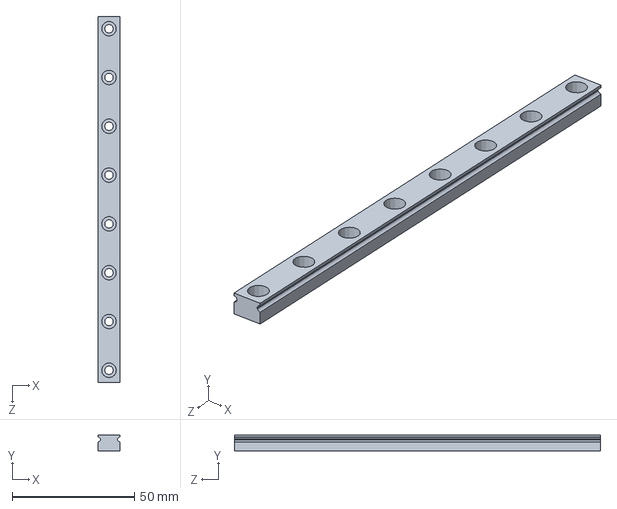
[picture p40: CAD file, 2026-06-05]
machine/sukinee/MGN9 Rail1.SLDPRT
9.00 x 6.50 x 150.0 mm
