xplusinxH/zhufeng-robotic-arm/machine/sukinee/腕部上下限位1.SLDPRT

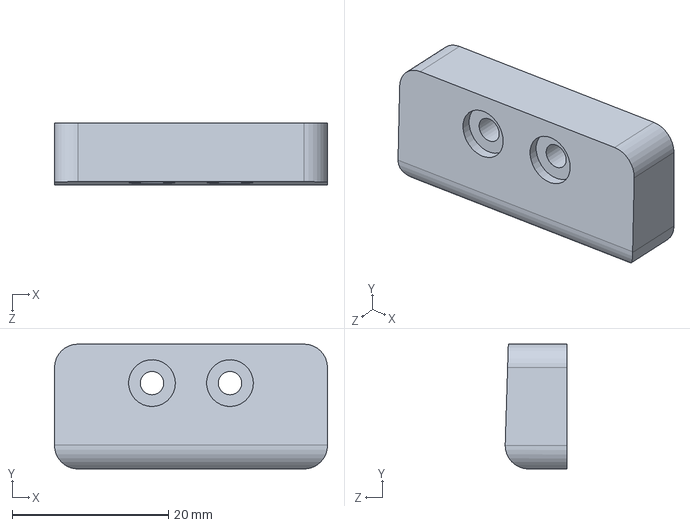
[picture p41: CAD file, 2026-06-05]
machine/sukinee/腕部上下限位1.SLDPRT
35.0 x 16.0 x 7.90 mm
