xplusinxH/zhufeng-robotic-arm/machine/sukinee/rs00.SLDPRT

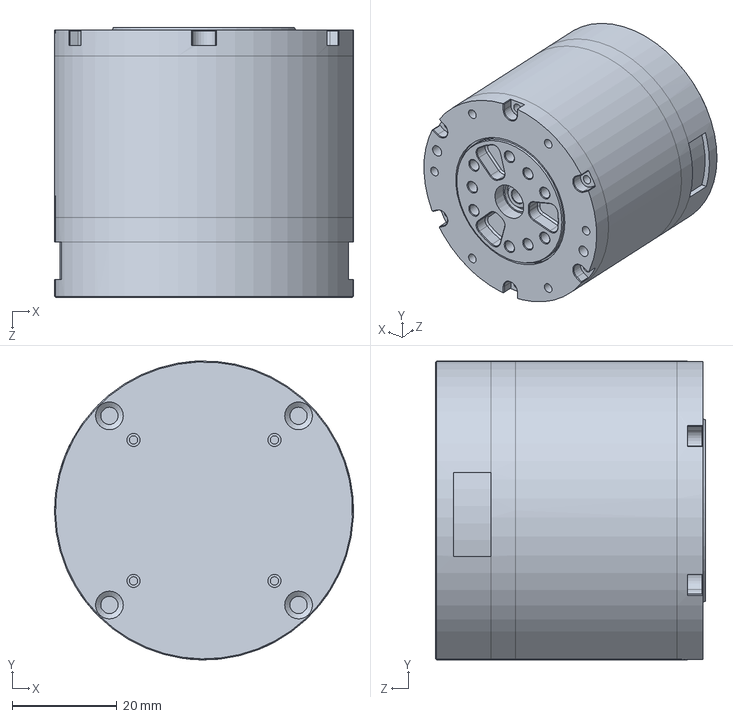
[picture p42: CAD file, 2026-06-05]
machine/sukinee/rs00.SLDPRT
57.0 x 57.0 x 51.4 mm
