xplusinxH/zhufeng-robotic-arm/machine/sukinee/MGN9-C 11.SLDPRT

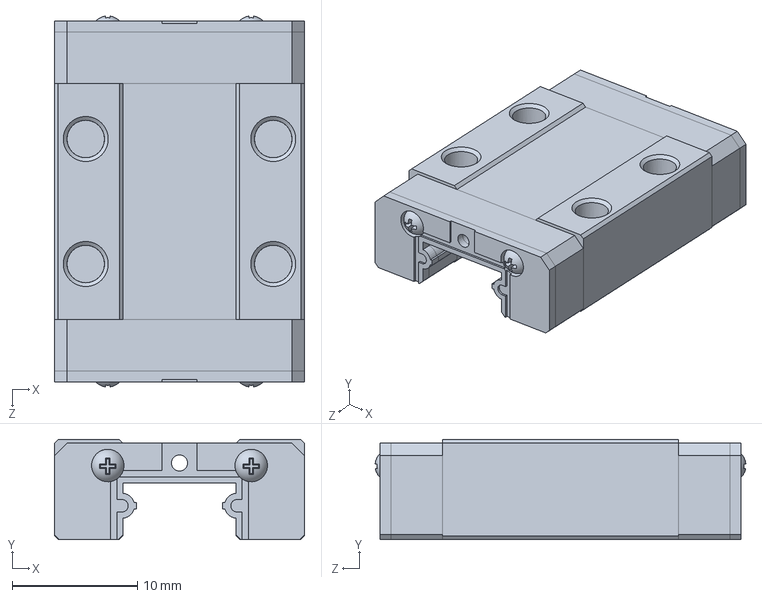
[picture p43: CAD file, 2026-06-05]
machine/sukinee/MGN9-C 11.SLDPRT
20.0 x 8.00 x 29.7 mm
