xplusinxH/zhufeng-robotic-arm/machine/sukinee/直齿M 0.9X17.SLDPRT

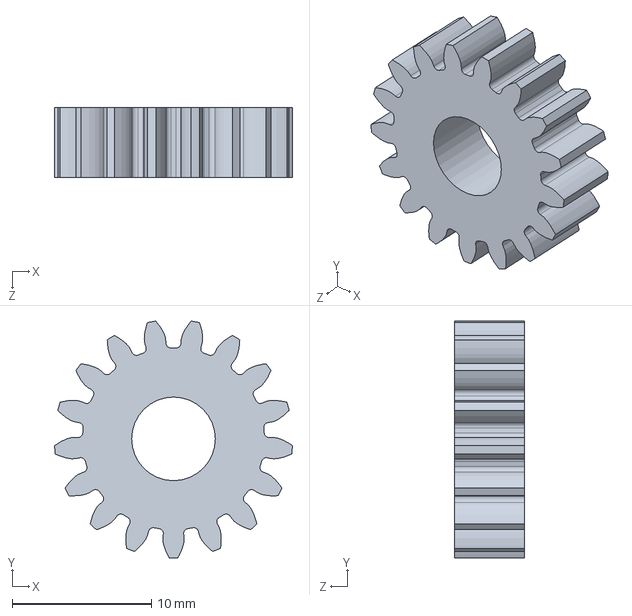
[picture p44: CAD file, 2026-06-05]
machine/sukinee/直齿M 0.9X17.SLDPRT
17.1 x 17.0 x 5.00 mm
