xplusinxH/zhufeng-robotic-arm/machine/sukinee/腕区连接打印件.SLDPRT

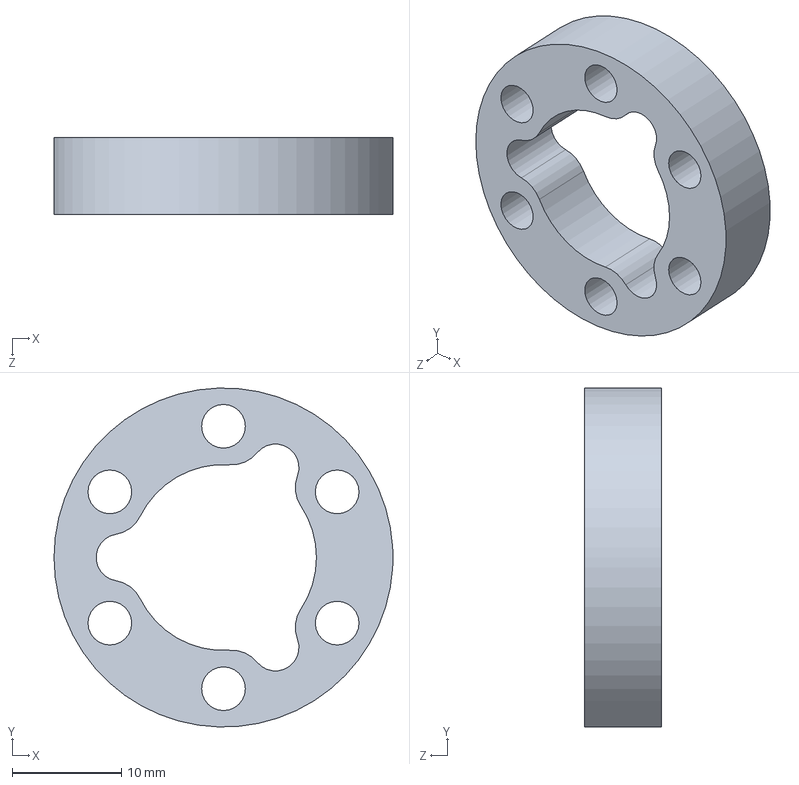
[picture p45: CAD file, 2026-06-05]
machine/sukinee/腕区连接打印件.SLDPRT
31.0 x 31.0 x 7.00 mm
