xplusinxH/zhufeng-robotic-arm/machine/sukinee/链条连接打印件.SLDPRT

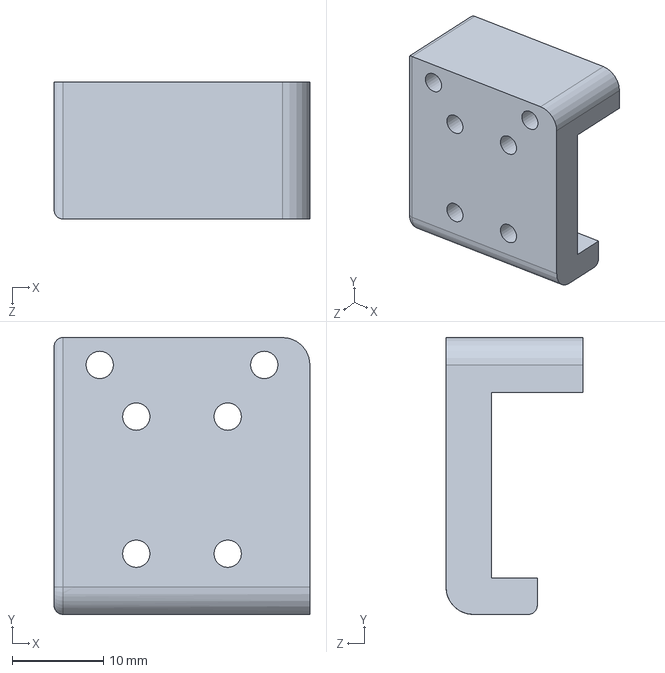
[picture p46: CAD file, 2026-06-05]
machine/sukinee/链条连接打印件.SLDPRT
28.0 x 30.3 x 15.0 mm
