xplusinxH/zhufeng-robotic-arm/machine/sukinee/腕部左右限位.SLDPRT

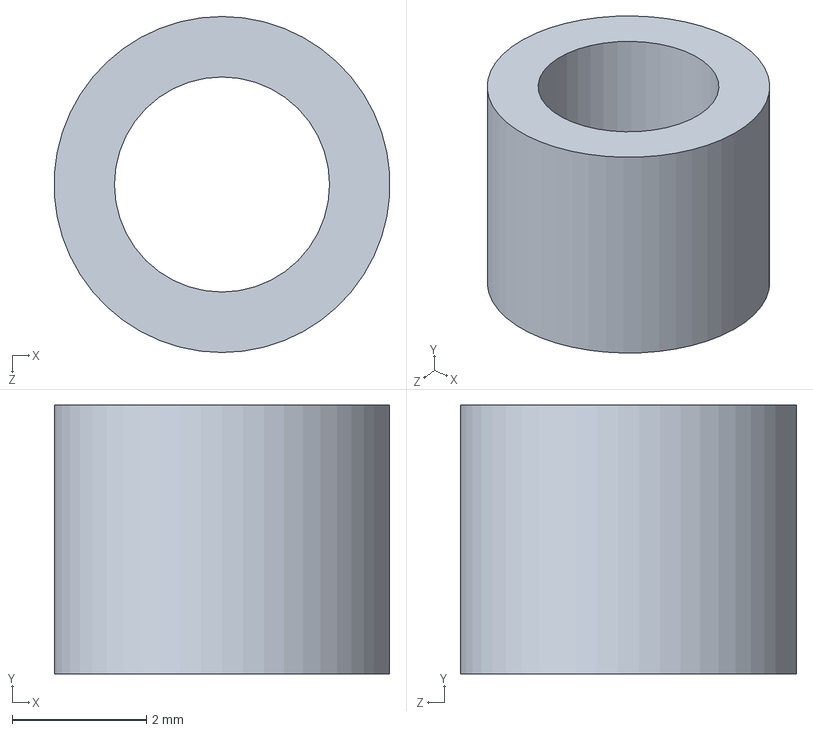
[picture p47: CAD file, 2026-06-05]
machine/sukinee/腕部左右限位.SLDPRT
4.99 x 4.00 x 5.00 mm
