xplusinxH/zhufeng-robotic-arm/machine/sukinee/肘部垫片右.SLDPRT

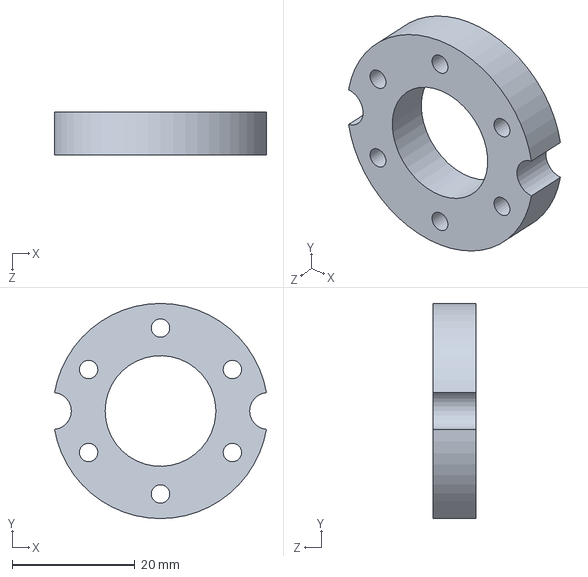
[picture p48: CAD file, 2026-06-05]
machine/sukinee/肘部垫片右.SLDPRT
34.5 x 35.0 x 7.00 mm
