xplusinxH/zhufeng-robotic-arm/machine/sukinee/导轨链接打印件1.SLDPRT

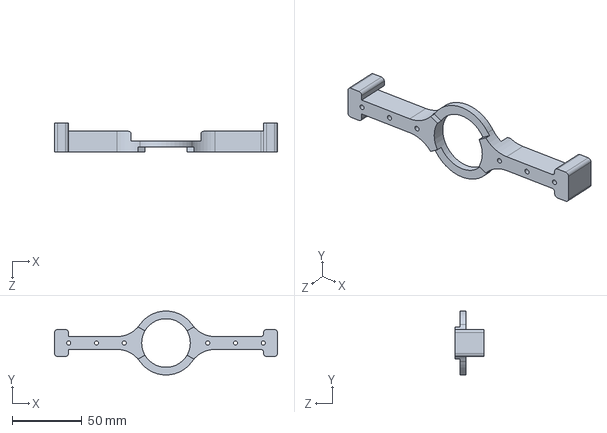
[picture p49: CAD file, 2026-06-05]
machine/sukinee/导轨链接打印件1.SLDPRT
160.4 x 46.0 x 21.0 mm
