xplusinxH/zhufeng-robotic-arm/machine/sukinee/夹爪自旋连接1.SLDPRT

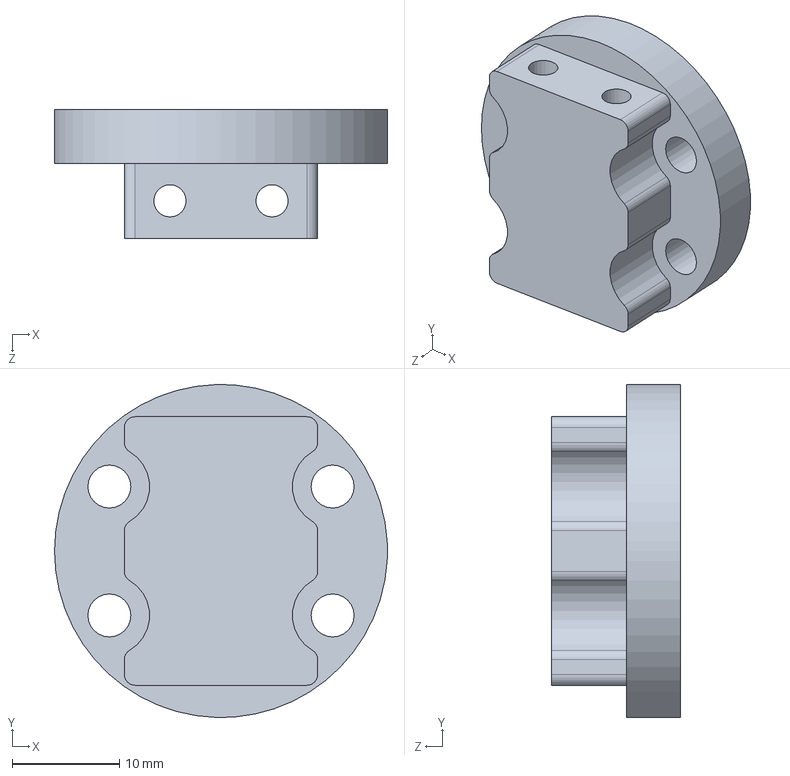
[picture p50: CAD file, 2026-06-05]
machine/sukinee/夹爪自旋连接1.SLDPRT
31.0 x 31.0 x 12.0 mm
