xplusinxH/zhufeng-robotic-arm/machine/sukinee/一级垫块.SLDPRT

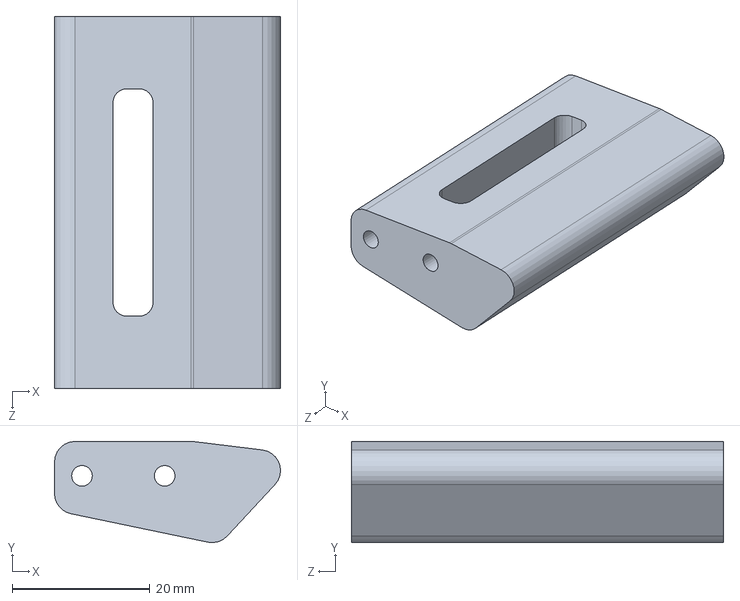
[picture p51: CAD file, 2026-06-05]
machine/sukinee/一级垫块.SLDPRT
32.8 x 14.7 x 54.0 mm
