xplusinxH/zhufeng-robotic-arm/machine/sukinee/大臂内填充1.SLDPRT

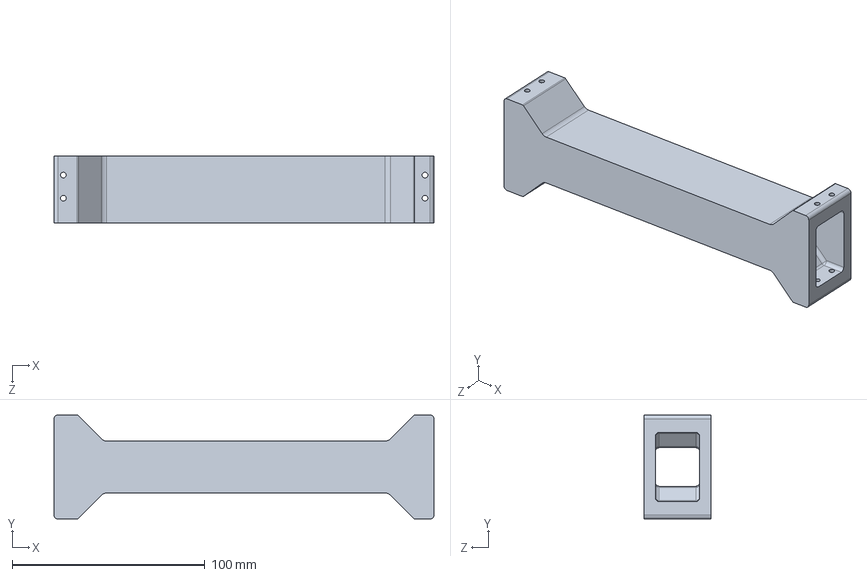
[picture p52: CAD file, 2026-06-05]
machine/sukinee/大臂内填充1.SLDPRT
197.4 x 54.0 x 35.0 mm
