xplusinxH/zhufeng-robotic-arm/machine/sukinee/小臂内填充1.SLDPRT

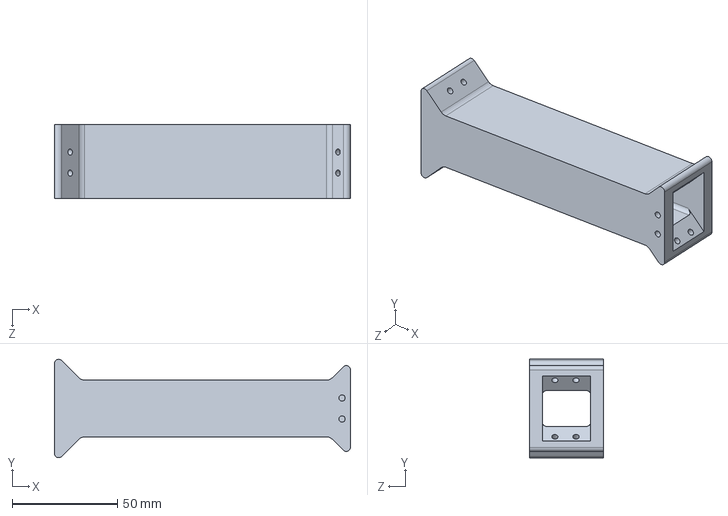
[picture p53: CAD file, 2026-06-05]
machine/sukinee/小臂内填充1.SLDPRT
140.8 x 46.9 x 35.0 mm
