xplusinxH/zhufeng-robotic-arm/machine/sukinee/云台基座.SLDPRT

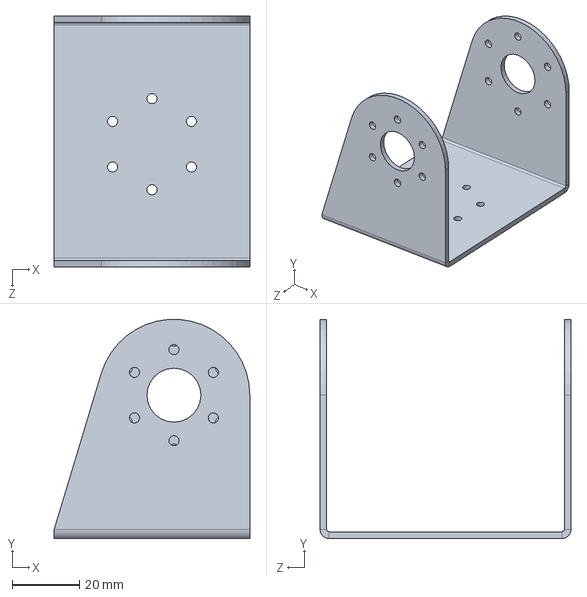
[picture p54: CAD file, 2026-06-05]
machine/sukinee/云台基座.SLDPRT
58.0 x 64.9 x 74.4 mm
