xplusinxH/zhufeng-robotic-arm/machine/sukinee/底座电机壳.SLDPRT

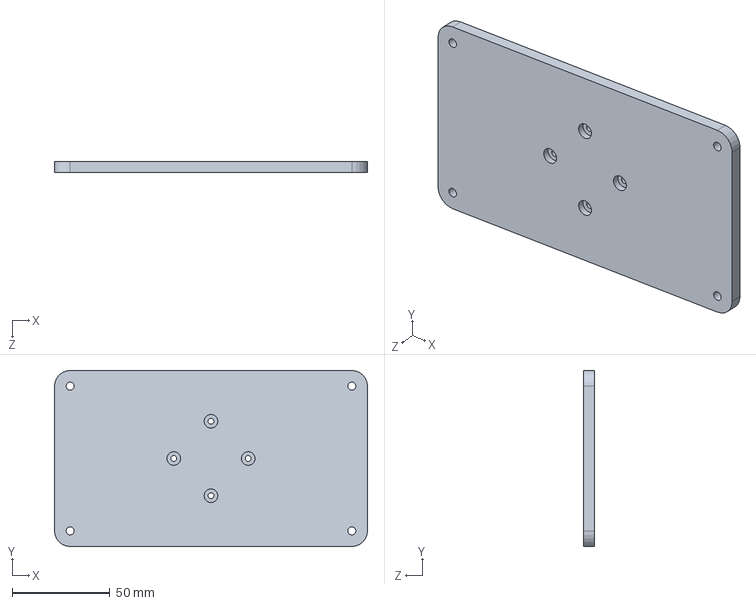
[picture p55: CAD file, 2026-06-05]
machine/sukinee/底座电机壳.SLDPRT
160.0 x 90.0 x 5.50 mm
