xplusinxH/zhufeng-robotic-arm/machine/sukinee/导轨链接钣金.SLDPRT

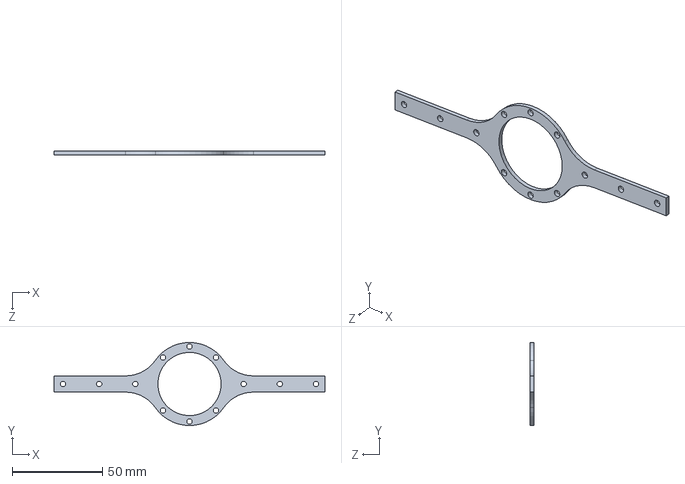
[picture p56: CAD file, 2026-06-05]
machine/sukinee/导轨链接钣金.SLDPRT
150.0 x 46.0 x 2.00 mm
