xplusinxH/zhufeng-robotic-arm/machine/sukinee/肘部轴承内连接.SLDPRT

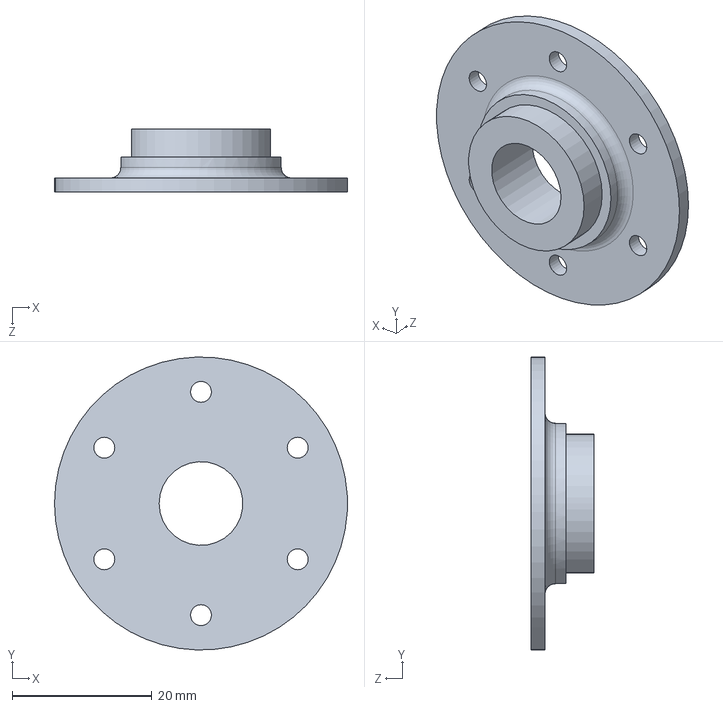
[picture p57: CAD file, 2026-06-05]
machine/sukinee/肘部轴承内连接.SLDPRT
42.0 x 42.0 x 9.00 mm
