xplusinxH/zhufeng-robotic-arm/machine/sukinee/20x27x4.SLDPRT

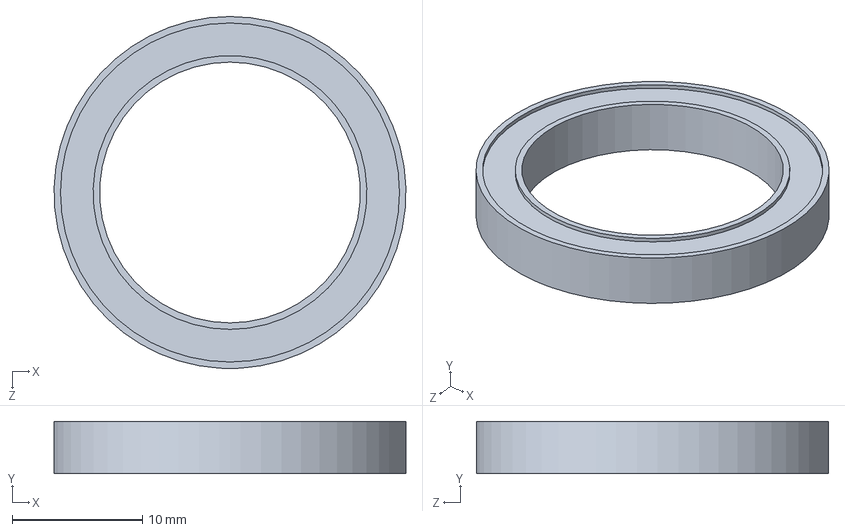
[picture p58: CAD file, 2026-06-05]
machine/sukinee/20x27x4.SLDPRT
27.0 x 4.00 x 27.0 mm
