xplusinxH/zhufeng-robotic-arm/machine/sukinee/肩部垫块2.SLDPRT

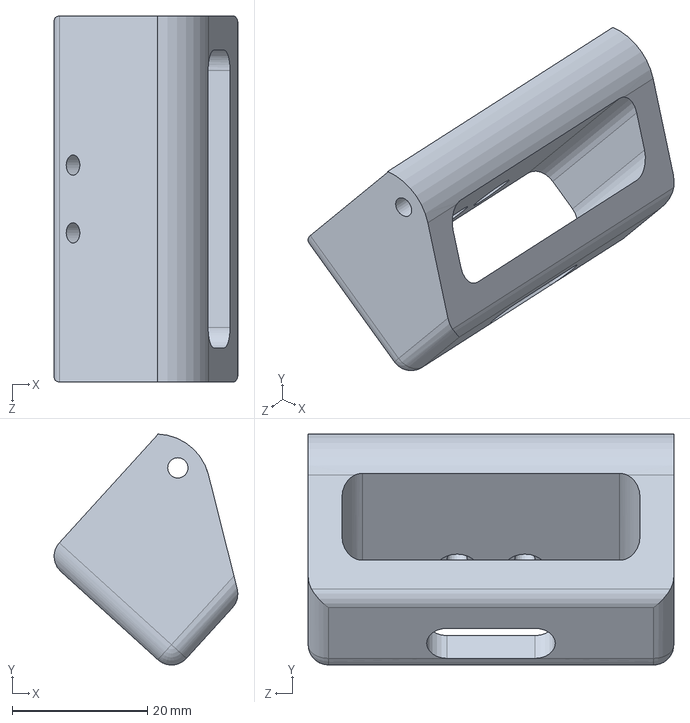
[picture p59: CAD file, 2026-06-05]
machine/sukinee/肩部垫块2.SLDPRT
27.1 x 34.1 x 54.0 mm
