xplusinxH/zhufeng-robotic-arm/machine/sukinee/肘部关节片.SLDPRT

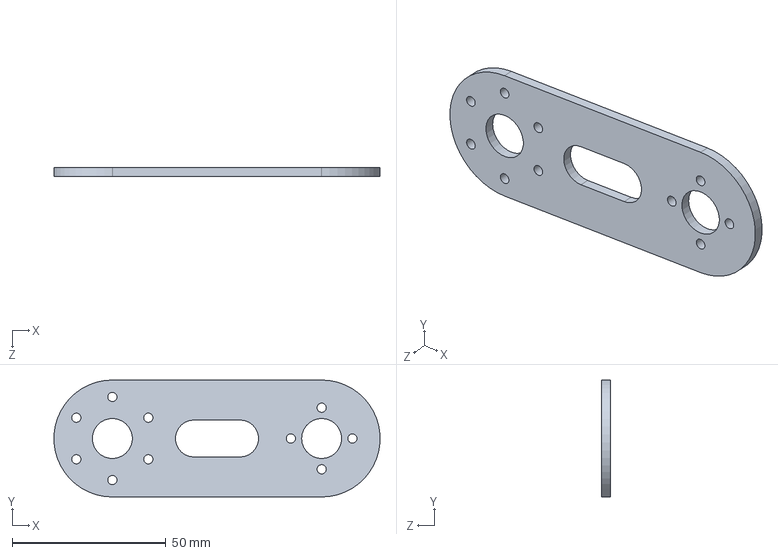
[picture p60: CAD file, 2026-06-05]
machine/sukinee/肘部关节片.SLDPRT
105.9 x 38.0 x 3.00 mm
