xplusinxH/zhufeng-robotic-arm/machine/sukinee/腕部钣金.SLDPRT

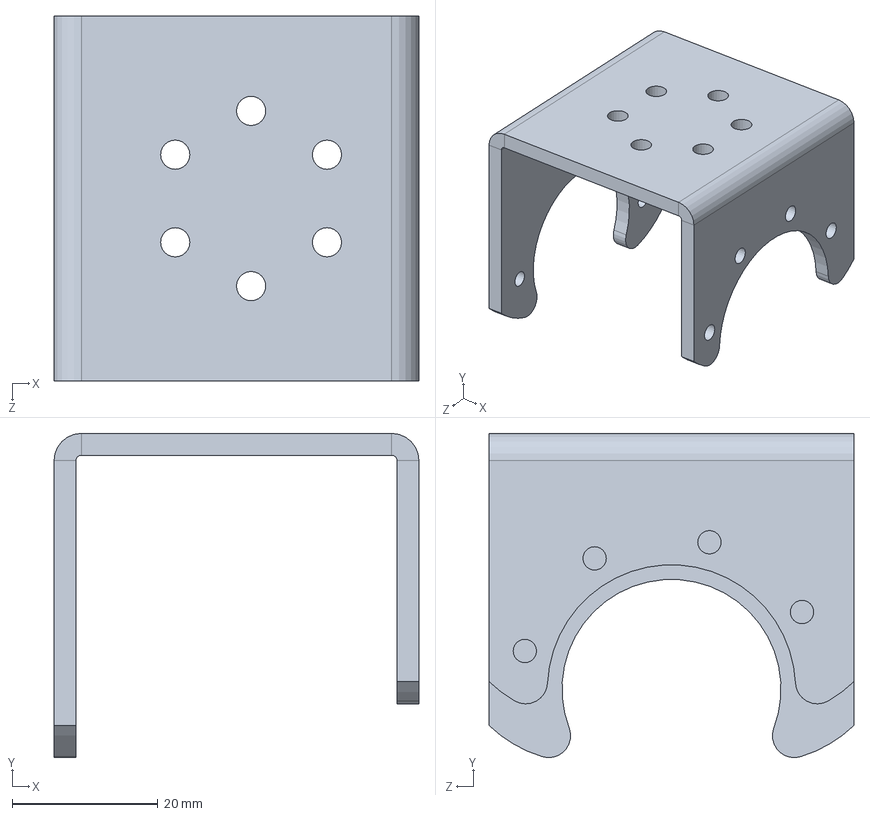
[picture p61: CAD file, 2026-06-05]
machine/sukinee/腕部钣金.SLDPRT
50.0 x 44.4 x 50.0 mm
