xplusinxH/zhufeng-robotic-arm/machine/sukinee/RS05.SLDASM

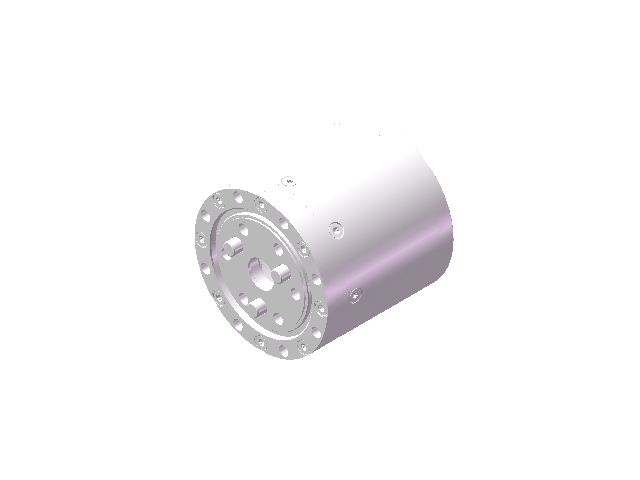
[picture p62: CAD file, 2026-06-05]
machine/sukinee/RS05.SLDASM
0001755650_00MINI-000_ASM_1_ASM_1_ASM_00MINI-_20250103_A0001_ASM_1_AS_ASM_1_1_30_GR-2202_ASM_1_ASM_1_1_30_GR-2202_ASM_FL46BLW10-48V-5N.m-DE(2)_FL46BLW10-48V-5N.
0001755652_00MINI-000_ASM_1_ASM_1_ASM_00MINI-_20250103_A0001_ASM_1_AS_ASM_1_1_30_GR-2202_ASM_1_ASM_1_1_30_GR-2202_ASM_FL46BLW10-48V-5N.m-DE(2)_FL46BLW10-48V-5N.
6706__300001_1_1_00MINI-000_ASM_1_ASM_1_ASM_00MINI-_20250103_A0001_ASM_1_AS_ASM_1_1_30_GR-2202_ASM_1_ASM_1_1_30_GR-2202_ASM_FL46BLW10-48V-5N.m-DE(2)_FL46BLW10-4
0001755652_1_1_30_GR-2202_ASM_1_ASM_1_1_30_GR-2202_ASM_FL46BLW10-48V-5N.m-DE(2)_FL46BLW10-48V-5N.m-DE.STEP x 2
1_1_06_EB463-507_FL46BLW10-48V-5N.m-DE(2)_FL46BLW10-48V-5N.m-DE.STEP
1_1_02_EB461-502_FL46BLW10-48V-5N.m-DE(2)_FL46BLW10-48V-5N.m-DE.STEP
1_2_05_000438_FL46BLW10-48V-5N.m-DE(2)_FL46BLW10-48V-5N.m-DE.STEP x 8
1_2_16_001425_FL46BLW10-48V-5N.m-DE(2)_FL46BLW10-48V-5N.m-DE.STEP
1_1_06_EB463-509_FL46BLW10-48V-5N.m-DE(2)_FL46BLW10-48V-5N.m-DE.STEP
1_2_05_020051_FL46BLW10-48V-5N.m-DE(2)_FL46BLW10-48V-5N.m-DE.STEP x 3
1_2_05_000608_FL46BLW10-48V-5N.m-DE(2)_FL46BLW10-48V-5N.m-DE.STEP x 4
1_1_31_EB463-510_FL46BLW10-48V-5N.m-DE(2)_FL46BLW10-48V-5N.m-DE.STEP
1_2_05_000555_FL46BLW10-48V-5N.m-DE(2)_FL46BLW10-48V-5N.m-DE.STEP x 8
