xplusinxH/zhufeng-robotic-arm/(list of files, cad)

Other CAD files:
machine/sukinee/Mirror小臂牌.SLDPRT
machine/sukinee/大臂外牌.SLDPRT
machine/sukinee/小臂钣金左.SLDPRT
machine/sukinee/齿条L82W5M 0.9.SLDPRT
