xplusinxH/zhufeng-robotic-arm/vision/calibration/README.md

# Calibration Files

Calibration outputs belong here:

- `camera_intrinsic.json`
- `extrinsic_se3.yaml`
- `sim3.yaml`
- `table_plane.yaml`
