xplusinxH/zhufeng-robotic-arm/vision/config.yaml

camera:
  width: 640
  height: 480
  fps: 30
  align_depth_to_color: true

depth:
  min_m: 0.15
  max_m: 1.20
  median_kernel: 7

table:
  min_above_table_m: 0.01
  max_above_table_m: 0.30

workspace:
  unit: mm
  output_transform: se3

serial:
  port: /dev/ttyUSB0
  baudrate: 115200
  bytesize: 8
  stopbits: 1
  parity: none
  encoding: ascii

apriltag:
  family: tag25h9
  base_tag_id: 0
  tool_tag_id: 1
  tag_size_mm: 80
  sample_frames: 15
  min_valid_frames: 5
  max_pose_age_ms: 500

logging:
  level: INFO
  directory: logs
