xplusinxH/zhufeng-robotic-arm/sukinee_ws/src/sukinee_moveit_config/config/joint_limits.yaml

default_velocity_scaling_factor: 0.2
default_acceleration_scaling_factor: 0.2

joint_limits:
  Joint1:
    has_velocity_limits: true
    max_velocity: 1.0
    has_acceleration_limits: true
    max_acceleration: 1.0

  Joint2:
    has_velocity_limits: true
    max_velocity: 1.0
    has_acceleration_limits: true
    max_acceleration: 1.0

  Joint3:
    has_velocity_limits: true
    max_velocity: 1.0
    has_acceleration_limits: true
    max_acceleration: 1.0

  Joint4:
    has_velocity_limits: true
    max_velocity: 1.5
    has_acceleration_limits: true
    max_acceleration: 1.5

  Joint5:
    has_velocity_limits: true
    max_velocity: 1.5
    has_acceleration_limits: true
    max_acceleration: 1.5

  Joint6:
    has_velocity_limits: true
    max_velocity: 1.5
    has_acceleration_limits: true
    max_acceleration: 1.5

  Joint7:
    has_velocity_limits: true
    max_velocity: 1.0
    has_acceleration_limits: true
    max_acceleration: 1.0
