xplusinxH/zhufeng-robotic-arm/vision/tools/serve_tag1_pose_serial.py

"""通过 Jetson 串口提供 AprilTag 6D 位姿采样服务。

运行环境：Jetson Nano + RealSense D435 + ``pupil_apriltags``。
收到 ``@GET_TAG_POSE#`` 后，程序连续采样多帧，计算
``tag_base_ref -> tag_tool0``，再返回一行 JSON。程序不控制机械臂、
不访问 CAN，也不写入电机参数。
"""

import argparse
from datetime import datetime
import sys
import time
from pathlib import Path

PROJECT_ROOT = Path(__file__).resolve().parents[1]
if str(PROJECT_ROOT) not in sys.path:
    sys.path.insert(0, str(PROJECT_ROOT))

from apriltag.detector import AprilTagPoseDetector
from apriltag.pose_sample import BaseReferenceCache, robust_average_transforms
from camera.realsense_camera import RealSenseCamera
from communication.tag_pose_protocol import (
    format_error,
    format_invalid_pose_sample,
    format_pose_sample,
    is_get_tag_pose_command,
    is_get_tool_command,
)
from coordinate.pose_transform import relative_transform
from tools.tag_debug_view import draw_debug_overlay, resize_debug_image, should_quit_from_key


def _intrinsics_to_camera_params(intrinsics):
    """把 RealSense 内参对象转换为 AprilTag 求解器需要的参数顺序。"""
    return (
        float(intrinsics.fx),
        float(intrinsics.fy),
        float(intrinsics.ppx),
        float(intrinsics.ppy),
    )


def run(
    serial_port,
    baudrate,
    tag_size_m,
    base_tag_id,
    tool_tag_id,
    sample_frames,
    min_valid_frames,
    base_cache_items,
    show=False,
    show_width=0,
    show_height=0,
    show_detect_every=1,
    frame_limit=None,
):
    """运行串口服务主循环。

    ``frame_limit`` 仅用于测试；现场运行时保持 ``None``，直到用户终止。
    """
    import cv2
    import numpy as np
    import serial

    camera = RealSenseCamera()
    detector = AprilTagPoseDetector()
    base_ref_cache = BaseReferenceCache(max_items=base_cache_items)
    serial_device = serial.Serial(serial_port, baudrate=baudrate, timeout=0)
    receive_buffer = ""
    handled_queries = 0
    debug_state = {
        "base_ref_source": "none",
        "last_status": "waiting",
        "detections": [],
        "frame_index": 0,
    }

    camera.start()
    try:
        camera_params = _intrinsics_to_camera_params(camera.get_color_intrinsics())
        print(
            "AprilTag 6D 位姿串口服务已启动：port={} baudrate={} tag_size_m={:.4f} base_id={} tool_id={} show={}".format(
                serial_port, baudrate, tag_size_m, base_tag_id, tool_tag_id, show
            )
        )
        while frame_limit is None or handled_queries < frame_limit:
            if show and _update_debug_window(
                camera=camera,
                detector=detector,
                camera_params=camera_params,
                tag_size_m=tag_size_m,
                base_tag_id=base_tag_id,
                tool_tag_id=tool_tag_id,
                np_module=np,
                cv2_module=cv2,
                debug_state=debug_state,
                show_width=show_width,
                show_height=show_height,
                show_detect_every=show_detect_every,
            ):
                break

            receive_buffer, query_count = _handle_serial_queries(
                serial_device=serial_device,
                receive_buffer=receive_buffer,
                camera=camera,
                detector=detector,
                camera_params=camera_params,
                tag_size_m=tag_size_m,
                base_tag_id=base_tag_id,
                tool_tag_id=tool_tag_id,
                sample_frames=sample_frames,
                min_valid_frames=min_valid_frames,
                next_seq=handled_queries + 1,
                np_module=np,
                base_ref_cache=base_ref_cache,
                debug_state=debug_state,
            )
            handled_queries += query_count
            time.sleep(0.001)
    except Exception as exc:
        try:
            serial_device.write((format_error(str(exc)) + "\n").encode("ascii", "ignore"))
        finally:
            raise
    finally:
        camera.stop()
        serial_device.close()
        if show:
            cv2.destroyAllWindows()


def _update_debug_window(
    camera,
    detector,
    camera_params,
    tag_size_m,
    base_tag_id,
    tool_tag_id,
    np_module,
    cv2_module,
    debug_state,
    show_width,
    show_height,
    show_detect_every,
):
    """刷新调试窗口。

    调试窗口只用于现场观察，不参与正式串口采样结果；为了降低负载，
    可通过 ``show_detect_every`` 降低调试检测频率。
    """
    color_frame, _depth_frame = camera.capture_aligned()
    color_bgr = np_module.asanyarray(color_frame.get_data()).copy()
    frame_index = int(debug_state.get("frame_index", 0))
    if _should_detect_debug_frame(frame_index, show_detect_every):
        try:
            debug_state["detections"] = detector.detect(
                color_bgr,
                camera_params=camera_params,
                tag_size_m=tag_size_m,
            )
        except Exception as exc:
            debug_state["last_status"] = "debug detect skipped: {}".format(exc)
    detections = debug_state.get("detections", [])
    debug_state["frame_index"] = frame_index + 1
    draw_debug_overlay(
        image_bgr=color_bgr,
        detections=detections,
        base_tag_id=base_tag_id,
        tool_tag_id=tool_tag_id,
        base_ref_source=debug_state.get("base_ref_source", "none"),
        last_status=debug_state.get("last_status", "waiting"),
    )
    color_bgr = resize_debug_image(
        image_bgr=color_bgr,
        width=show_width,
        height=show_height,
        cv2_module=cv2_module,
    )
    cv2_module.imshow("Sukinee AprilTag Debug", color_bgr)
    return should_quit_from_key(cv2_module.waitKey(1))


def _handle_serial_queries(
    serial_device,
    receive_buffer,
    camera,
    detector,
    camera_params,
    tag_size_m,
    base_tag_id,
    tool_tag_id,
    sample_frames,
    min_valid_frames,
    next_seq,
    np_module,
    base_ref_cache,
    debug_state,
):
    """读取串口缓冲区并处理完整命令帧。"""
    data = serial_device.read(256)
    if data:
        receive_buffer += data.decode("ascii", "ignore")

    query_count = 0
    while "#" in receive_buffer:
        frame, receive_buffer = receive_buffer.split("#", 1)
        message = frame + "#"
        if is_get_tag_pose_command(message):
            response, status = _capture_pose_sample_json(
                camera=camera,
                detector=detector,
                camera_params=camera_params,
                tag_size_m=tag_size_m,
                base_tag_id=base_tag_id,
                tool_tag_id=tool_tag_id,
                sample_frames=sample_frames,
                min_valid_frames=min_valid_frames,
                seq=next_seq + query_count,
                np_module=np_module,
                base_ref_cache=base_ref_cache,
            )
            debug_state["base_ref_source"] = status["base_ref_source"]
            debug_state["last_status"] = status["last_status"]
            serial_device.write((response + "\n").encode("utf-8"))
            print("serial <= {}  => {}".format(message, response))
            query_count += 1
        elif is_get_tool_command(message):
            response = format_error("deprecated command; use @GET_TAG_POSE#")
            debug_state["last_status"] = "deprecated command"
            serial_device.write((response + "\n").encode("ascii", "ignore"))
    return receive_buffer[-128:], query_count


def _capture_pose_sample_json(
    camera,
    detector,
    camera_params,
    tag_size_m,
    base_tag_id,
    tool_tag_id,
    sample_frames,
    min_valid_frames,
    seq,
    np_module,
    base_ref_cache,
):
    """采集一个 6D 位姿样本并返回 JSON 字符串。

    采样策略：
    - 看到底座 tag 时更新底座参考缓存。
    - 看不到底座 tag 但缓存可用时，使用缓存继续计算末端位姿。
    - 有效帧不足时仍返回 JSON，但 ``position_m`` 和 ``orientation_xyzw`` 为 ``null``。
    """
    valid_relative_transforms = []
    base_ref_seen = False
    tool0_seen = False
    used_cached_base = False
    used_live_base = False

    for _index in range(sample_frames):
        color_frame, _depth_frame = camera.capture_aligned()
        color_bgr = np_module.asanyarray(color_frame.get_data())
        try:
            detections = detector.detect_camera_to_tag(
                color_bgr,
                camera_params=camera_params,
                tag_size_m=tag_size_m,
            )
        except Exception as exc:
            print("AprilTag frame skipped: {}".format(exc))
            continue
        base_ref_seen = base_ref_seen or base_tag_id in detections
        tool0_seen = tool0_seen or tool_tag_id in detections

        # 底座 tag 通常固定在机械臂底座附近，缓存它可以降低遮挡造成的采样失败率。
        if base_tag_id in detections:
            base_ref_cache.add(detections[base_tag_id])

        if tool_tag_id not in detections:
            continue

        camera_to_base = None
        if base_tag_id in detections:
            camera_to_base = detections[base_tag_id]
            used_live_base = True
        elif base_ref_cache.has_value():
            camera_to_base = base_ref_cache.get_fused()
            used_cached_base = True

        if camera_to_base is not None:
            valid_relative_transforms.append(
                relative_transform(camera_to_base, detections[tool_tag_id])
            )

    timestamp = _timestamp_now()
    sample_id = "S{:04d}".format(seq)
    base_ref_source = _base_ref_source(used_live_base, used_cached_base)
    if len(valid_relative_transforms) < min_valid_frames:
        return (
            format_invalid_pose_sample(
                sample_id=sample_id,
                seq=seq,
                timestamp_jetson=timestamp,
                tag_size_m=tag_size_m,
                frame_count_used=len(valid_relative_transforms),
                base_ref_seen=base_ref_seen,
                tool0_seen=tool0_seen,
                base_ref_source=base_ref_source,
                tag_base_ref_id=base_tag_id,
                tag_tool0_id=tool_tag_id,
            ),
            {"base_ref_source": base_ref_source, "last_status": "invalid sample"},
        )

    fused_transform = robust_average_transforms(valid_relative_transforms)
    return (
        format_pose_sample(
            sample_id=sample_id,
            seq=seq,
            timestamp_jetson=timestamp,
            transform=fused_transform,
            tag_size_m=tag_size_m,
            frame_count_used=len(valid_relative_transforms),
            base_ref_seen=base_ref_seen,
            tool0_seen=tool0_seen,
            base_ref_source=base_ref_source,
            tag_base_ref_id=base_tag_id,
            tag_tool0_id=tool_tag_id,
        ),
        {"base_ref_source": base_ref_source, "last_status": "ok"},
    )


def _base_ref_source(used_live_base, used_cached_base):
    """描述本次样本使用的底座参考来源。"""
    if used_live_base and used_cached_base:
        return "mixed"
    if used_live_base:
        return "live"
    if used_cached_base:
        return "cached"
    return "none"


def _timestamp_now():
    """生成 Jetson 本地时间戳。"""
    return datetime.now().isoformat(timespec="milliseconds")


def _should_detect_debug_frame(frame_index, show_detect_every):
    """判断调试窗口当前帧是否需要运行 AprilTag 检测。"""
    interval = max(1, int(show_detect_every or 1))
    return int(frame_index) % interval == 0


def main():
    parser = argparse.ArgumentParser(description=__doc__)
    parser.add_argument("--serial-port", default="/dev/ttyUSB0", help="串口设备路径")
    parser.add_argument("--baudrate", type=int, default=115200, help="串口波特率")
    parser.add_argument("--tag-size-mm", type=float, required=True, help="AprilTag 黑色外框边长，单位毫米")
    parser.add_argument("--base-tag-id", type=int, default=0, help="底座参考 tag id")
    parser.add_argument("--tool-tag-id", type=int, default=1, help="末端 tool0 tag id")
    parser.add_argument("--sample-frames", type=int, default=15, help="每个 sample 连续采集帧数")
    parser.add_argument("--min-valid-frames", type=int, default=5, help="最少有效 tool0 帧数")
    parser.add_argument("--base-cache-items", type=int, default=20, help="缓存的底座参考观测数量")
    parser.add_argument("--show", action="store_true", help="在 Jetson 屏幕显示 AprilTag 调试窗口")
    parser.add_argument("--show-width", type=int, default=0, help="调试窗口显示宽度，0 表示使用原始宽度")
    parser.add_argument("--show-height", type=int, default=0, help="调试窗口显示高度，0 表示按比例计算")
    parser.add_argument("--show-detect-every", type=int, default=1, help="调试窗口每隔多少帧运行一次 AprilTag 检测")
    parser.add_argument("--frames", type=int, help="测试用：处理指定查询次数后退出")
    args = parser.parse_args()

    run(
        serial_port=args.serial_port,
        baudrate=args.baudrate,
        tag_size_m=args.tag_size_mm / 1000.0,
        base_tag_id=args.base_tag_id,
        tool_tag_id=args.tool_tag_id,
        sample_frames=args.sample_frames,
        min_valid_frames=args.min_valid_frames,
        base_cache_items=args.base_cache_items,
        show=args.show,
        show_width=args.show_width,
        show_height=args.show_height,
        show_detect_every=args.show_detect_every,
        frame_limit=args.frames,
    )
    return 0


if __name__ == "__main__":
    raise SystemExit(main())
