xplusinxH/zhufeng-robotic-arm/(commit log)

2026-06-05 Add machine CAD files
    [20x27x4.SLDPRT, D435固定.SLDPRT, MGN9 Rail1.SLDPRT, MGN9-C 11.SLDPRT, Mirror大臂外牌.SLDPRT, Mirror小臂牌.SLDPRT, RS05.SLDASM, rs00.SLDPRT]
2026-06-05 Add robotic arm image to machine README
2026-06-14 Add Sukinee ROS2 robotic arm workspace
    [Link1.STL, Link2.STL, Link7.STL, Link8.STL, Link_l.STL, Link_r.STL, base_link.STL, joint_limits.yaml]
2026-06-14 Document Jetson D435 RSUSB environment design
2026-06-14 添加 Jetson D435 中文实施计划
2026-06-14 明确 Jetson 项目存储分配
2026-06-14 实现 D435 对齐采集封装
2026-06-14 添加 Jetson 视觉部署目录
2026-06-14 记录 D435 视觉环境阶段成果
2026-06-15 设计 D435 内参与对齐验证流程
2026-06-15 规划 D435 内参与对齐验证实施
2026-06-15 实现 D435 内参与实时对齐验证
2026-06-18 记录 AprilTag 末端坐标临时任务
    [D435固定.SLDPRT, Mirror大臂外牌.SLDPRT, Mirror小臂牌.SLDPRT, 大臂外牌.SLDPRT, 夹爪.SLDPRT, 夹爪连接打印件.SLDPRT, 小臂牌.SLDPRT, 小臂钣金右2.SLDPRT]
2026-06-18 实现 AprilTag 末端坐标串口服务
2026-06-18 更新 AprilTag 默认尺寸为 80mm
2026-06-18 更新 AprilTag 6D 位姿输出规格
2026-06-18 升级 AprilTag 串口输出为 6D 位姿 JSON
2026-06-18 切换 AprilTag family 为 tag25h9
2026-06-18 支持底座 AprilTag 缓存参考位姿
2026-06-18 添加 AprilTag 调试显示窗口
2026-06-18 调整 AprilTag 底座和末端 ID 约定
2026-06-18 增强 AprilTag 调试窗口显示参数
2026-06-18 跳过 AprilTag 单帧求解异常
2026-06-21 Update Sukinee workspace under sukinee_ws
    [residuals_train.csv, sukinee_motor_to_urdf_offsets_calibrated.json]
2026-06-28 Add YOLO desktop vision workflow
    [D435固定.SLDPRT, Mirror大臂外牌.SLDPRT, Mirror小臂牌.SLDPRT, 垫片2.SLDPRT, 大臂填充.SLDPRT, 小臂.SLDPRT, 小臂牌.SLDPRT, 小臂钣金右2.SLDPRT]
